jfri2/EV_FET_DRIVER/Hardware/notes.txt

===================================================================================================
Design Notes
===================================================================================================

===================================================================================================
Clock Selection

ATMEGA328PB Requirements:
 - Use external 16 MHz external clock, ceramic resonator or crystal w/out any clkdiv fuses set
 - General input reqs (assume Vcc = 5.0 VDC):
    - XTAL1 input low voltage: -0.5 to 0.5 VDC
    - XTAL1 input high voltage: 3.5 to 5.5 VDC
    - XTAL2 follows GPIO min/max. If used w/crystal or ceramic resonator reqs don't matter
 - External clock reqs:
    - 50 ns minimum clock period
    - 20 ns minimum high time
    - 20 ns minimum low time
    - Max 0.5 us rise time
    - Max 0.5 us fall time
    - 2% maximum jitter

---    
    
Ceramic Oscillator CSTCE16M0V13L99-R0 16 MHz Ceramic Resonator w/ Built in Load Capacitors

CSTCE16M0V13L99-R0
    Initial freq tolerance:                 +/- 0.1%
    Max freq shift (temperature):           +/- 0.15%
    Frequency stability:                    +/- 0.3%
                                            ---------
    Maximum frequency shift (initial):      +/- 0.55% (152 kHz)
    Maximum frequency shift (operating):    +/- 0.45% (72 kHz)
    
Benefits:
    - Small
    - Easy to use
    - Only 1 part required
    - Lowish power
    - Extremely cheap
    
Drawbacks
    - Crappy frequency stability (Up to 4500 ppm off!)
    - Uses two GPIO pins
    - Not very noise immune
 
---

External Oscillator (TTL Clock) ECS-3961-160-AU-TR 16 MHz HCMOS XO Oscillator

ECS-3961-160-AU-TR
    Frequency stability:        +/-100 ppm (+/- 1.6 kHz)
    High output:                4.5 to 5.0 VDC
    Low output:                 0.0 to 
    Output load: Max            30 pF
    Rise time: Max              5 ns
    Fall time: Max              5 ns
    Startup time:               10 ms
    Input current:              20 mA
    
Benefits:
    - Small
    - Great frequency stability
    - Cheapish
    - Very robust
    - Uses only one GPIO pin
    - Can disable output

Drawbacks:
    - Requires external decoupling capacitor
    - Slightly more invovled design

---
    
Selection: ECS-3961-160-AU-TR 16 MHz HCMOS XO Oscillator
===================================================================================================

===================================================================================================
Buck Converter/Power Supply Design

Component References
    R45      = Low value series resistor for inrush limiting (ERJ-8CWJR050V, 1206 package)
    C3/C4/C5  Bulk capacitors
    U2       = LMR16010 Buck Regulator
    C7/C9    = Input Caps (1x 4.7 uF, 1x 100nF)
    R17      = RT/SYNC resistor = 45.3 kOhm (RC0603FR-0745K3L)
    C16      = Bootstrap Capacitors
    D2       = Flyback diode
    L1       = Output inductor
    R25      = feedback resistor (high)
    R26      = feedback resistor (low)
    C21      = Output capacitor
    C25/C26  = Extra output capacitors (2x 4.7 uF, away from U2)
    C43      = Feedback cap = 27 pF (C0603C270J5GACTU)
===================================================================================================    
D2 Selection
 - All diodes must be same type on this board
 - Breakdown voltage must be > 48 VDC + 25% = 60 VDC (48 VDC is highest voltage per gate driver circuitry)
 - Must be < 0.7 Forward voltage drop @ minimum 100 mA
 - Must be tweezer-placable surface mount package
 - At least 2A cont. rated
 - Preference given to fastest & lowest forward voltage drop device that meets these requirements 

Selected component: PMEG6030ETP
 - Technology: Schottky
 - Reverse voltage: min 60 VDC
 - Reverse current: typ 80 uA
 - Forward current range (Vf < 0.7 VDC): 
 - Max Vf in range: 590 mV (3A)
 - Typical Vf for <1 A: 350 mV
 - Reverse recovery time: 12 ns
 - Capacitance: 360 pF @ 1 V, 1 MHz
 - Package: SOD-128
=================================================================================================== 
Input/Output Capacitors (all 4.7uF & 100 nF caps on board) Selection:
 - Must be X7R or X5R Ceramic
 - At least 30 VDC rated (2x 15Vin)
 - ESR < 100 mOhms @ 1 MHz
 - +/- 5% or better (100nF), +/- 10% or better (4.7uF)
 - Tweezer placable SMD package
 
Selected 4.7 uF capacitor: CL31B475KBHVPNE
 - Voltage Rating: 50 VDC
 - ESR: Lowish
 - Package: 1206
 
Selected 100nF capacitor: CC0603JRX7R9BB104
 - Voltage Rating: 50 VDC
 - ESR: < 100mOhm @ 1 MHz
 - Package: 0603
=================================================================================================== 
Bulk Capacitors
 - At least 30 VDC rated (2x 15Vin)
 - At least 150 uF each
 - ESR < 500 mOhms
 - Surface mount, lowish profile
 
Selected capacitors: AFK157M50G24T-F
 - Voltage Rating: 50 VDC
 - ESR: 180 mOhm
 - Size: 10.00 mm dia x 10.50 mm height
===================================================================================================  
Feedback Resistors
 - Output voltage set using following equation (R_top is R25, R_bot is R26):
R_top = ((5.0 VDC - 0.75) * R_bot) / 0.75
If R_top = 100 kOhm (0.1%), R_bot = 17.65 kOhm

V_actual = 4.96348 VDC
Use 1% or better resistors

Selected R_top: RC0603FR-07100KL
 - Package: 0603
Selected R_bot: RC0603FR-0717K8L
 - Package: 0603
 
TI WEBENCH Design Center:
R_top = 68.0 kOhm
R_bot = 12.0 kOhm

Selected R_Top: 68.0 kOhm
 - Package: 0603
Selected R_Bot: 12.0 kOhm
 - Package: 0603
===================================================================================================  
Output Inductor & Capacitor

Datasheet
 - Switching Frequency: 1912 kHz
 - Max input voltage: 18 VDC
 - Max peak-to-peak ripple current 
 - Kind = 50% [50 mA to 250 mA] current range
 - Inductor should be capable of 500 mArms & 1 A saturation current
 - delta_I =((Vout * (Vin_max - Vout)) / (Vin_max * L * Fsw))
 - delta_I = 0.2 * 250 mA = 50 mA
 - Lmin = ((Vin_max - Vout) / (Iout * Kind)) * (Vout / (Vin_max * Fsw))
 - Lnominal = 37.7 uH
 - Lmin = 15.1 uH
 - Needs to be ferrite inductor
 - Equates to 85% efficiency

TI WEBENCH Design Center:

Selected L: SDR0604-680KL
 - Inductance: 68.0 uH
 - ESR: 0.520 Ohm
===================================================================================================

=================================================================================================== 
MCP 6561 (Comparator) calculations

R18 & R19 resistor divider:
 - scale input down from [5.5 VDC to 18 VDC] to [0 VDC to 5 VDC] ish: 26k & 10k resistors. 10.5 VDC = 2.917 VDC out
 - Vtrip_low_to_high = around 10.5 VDC
 - Vtrip_high_to_low = around 11.0 VDC
 
 - R2 = Rtop (R22)
 - R3 = Rbot (R23), assume 10k
 - Rf = Rfeedback (R24), assume 470k
 
 - R23 = (R2 * R3) / (R2 + R3)
 - V23 = (Vdd * (R3 / (R2 + R3))) 
 - Vtrip_low_to_high = (Voh * (R23 / (R23 + Rf))) + (V23 * (Rf / (R23 + Rf)))
 - Vtrip_high_to_low = (Vol * (R23 / (R23 + Rf))) + (V23 * (Rf / (R23 + Rf)))

 w/ [R2, R3, Rf] = [6.8k, 10k, 500k]:
 - Vtrip_low_to_high = 2.9523 VDC (10.628 VDC in)
 - Vtrip_high_to_low = 2.9924 VDC (10.773 VDC in)
 
 w/ [R2, R3, Rf] = [7.2k, 10k, 500k]:
 - Vtrip_low_to_high = 2.8828 VDC (10.528 VDC in)
 - Vtrip_high_to_low = 2.9244 VDC (10.378 VDC in)
