jfri2/EV_FET_DRIVER/Hardware/3-Phase-Inverter-Controller.pdf

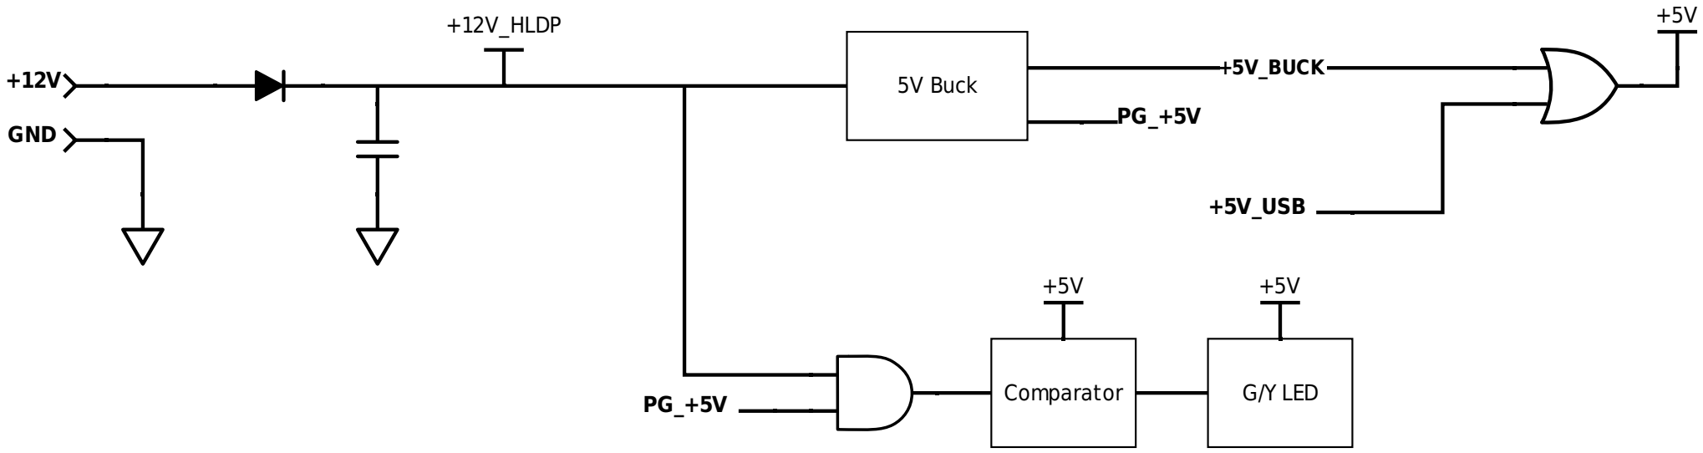
[picture p1: figure]
5V Buck; +5V_BUCK +12V; GND; +5V_USB; Comparator; G/Y LED; +12V_HLDP
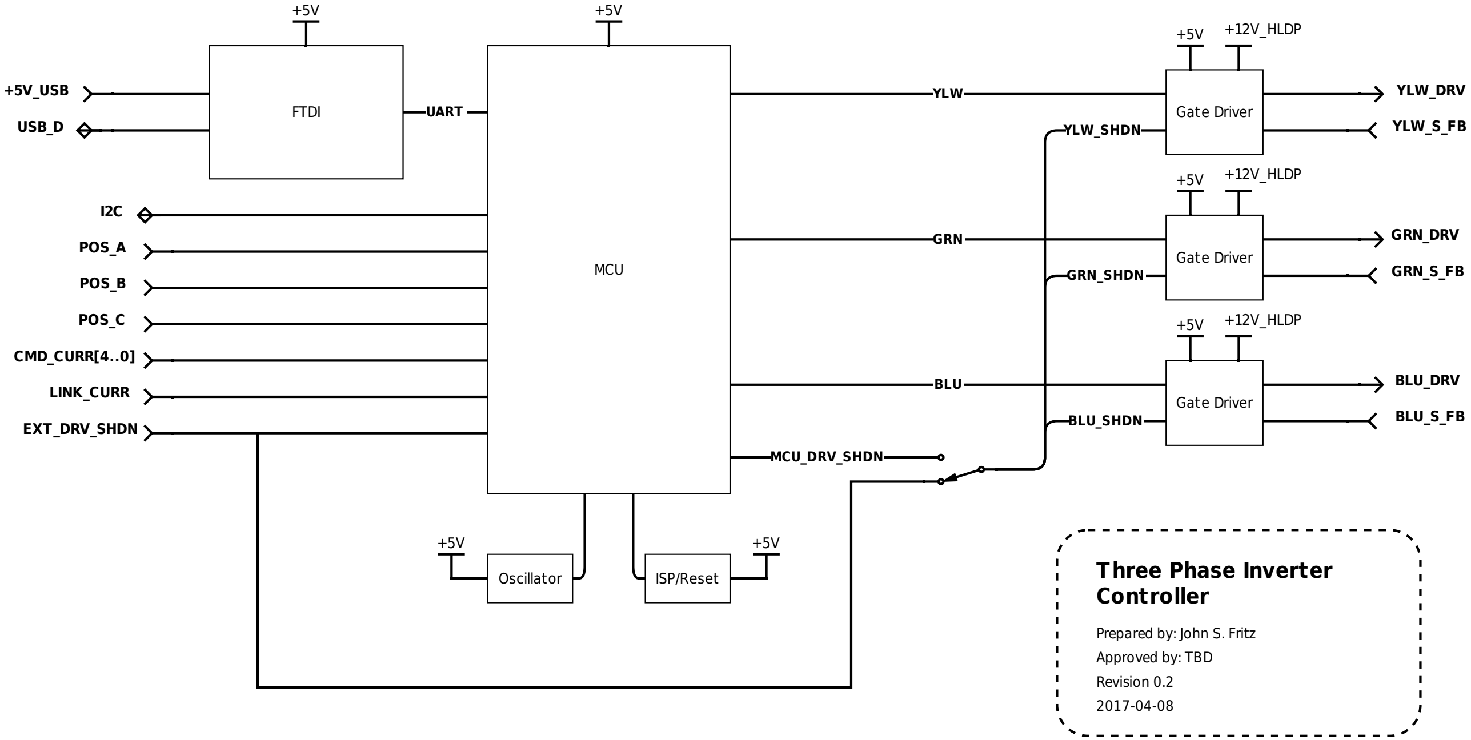
[picture p2: figure]
Three Phase Inverter Controller; Revision 0.2; Prepared by: John S. Fritz Approved by: TBD; YLW_DRV; USB_D; +5V_USB; CMD_CURR[4..0]; LINK_CURR; EXT_DRV_SHDN; FTDI; MCU; UART; Oscillator; ISP/Reset; Gate Driver; MCU_DRV_SHDN; BLU_SHDN; GRN_SHDN; YLW_SHDN; YLW; GRN; BLU; POS_C; YLW_S_FB; GRN_DRV; GRN_S_FB; BLU_DRV; BLU_S_FB; POS_A; POS_B; +12V_HLDP
