jfri2/EV_FET_DRIVER/Hardware/Three_Phase_Inverter_Controller.ods

Reference | Quantity x1 | Quantity x3 | Value | Footprint | MFG # | Comments
AA1 AA3 AA5 | 3 | 9 | OUT_1_H |  |  | Schematic ref only
AA2 AA4 AA6 | 3 | 9 | OUT_1_L |  |  | Schematic ref only
C2 | 1 | 3 | 4.5nF | 0603 | CL10B472KB8NNNC
C3 C4 C5 | 3 | 9 | 150uF | Custom | AFK157M50G24T-F
C1 C10 C11 C12 C13 C15 C16 C17 C18 C19 C22 C23 C24 C27 C30 C31 C32 C33 C40 C41 C42 C44 C6 C8 C9 | 25 | 75 | 100nF | 0603 | CC0603JRX7R9BB104
C14 C20 C21 C25 C26 C28 C29 C34 C35 C36 C37 C38 C39 C7 | 14 | 42 | 4.7uF | 1206 | CL31B475KBHVPNE
C43 | 1 | 3 | 27pF | 0603 | CL10C270JB8NNNC
D3 | 1 | 3 | LNJ167W8RRA | Custom | LNJ167W8RRA
D1 D2 D4 D5 D6 | 5 | 15 | PMEG6030ETP | SOD-128 | PMEG6030ETP
J1 | 1 | 3 | POWER | 0.1” Header, 1x2, TH R |  | Female
J3 | 1 | 3 | CURRENT | 0.1” Header, 1x8, TH R |  | Female
J4 | 1 | 3 | I2C | 0.1” Header, 1x4, TH R |  | Female
J5 | 1 | 3 | SPARE | 0.1” Header, 1x4, TH R |  | Female
J6 | 1 | 3 | UART | 0.1” Header, 1x4, TH R |  | Female
J7 | 1 | 3 | USB_B | Custom SMD USB B | 62910416121
J8 | 1 | 3 | ISP | 0.1” Header, 2x3, TH |  | Male
J2 | 1 | 3 | HALL | 0.1” Header, 1x4, TH | 282834-4 | Screw Terminal
JP1 | 1 | 3 | HALL_P_EN | 0.1” Header, 1x2, TH |  | Male
JP2 | 1 | 3 | I2C_SDA | 0.1” Header, 1x2, TH |  | Male
JP3 | 1 | 3 | I2C_SCL | 0.1” Header, 1x2, TH |  | Male
JP4 | 1 | 3 | SD | 0.1” Header, 1x2, TH |  | Male
JP5 | 1 | 3 | SHDN_SELECT | 0.1” Header, 1x3, TH |  | Male
L1 | 1 | 3 | 68uH | Custom | SDR0604-680KL
Q1 Q2 Q3 Q4 Q5 Q6 | 0 | 0 | IXFN110N60P3 | Custom |  | Already owned
Q7 | 1 | 3 | BSS806NE | SOT-23 | BSS806NE
R1 | 1 | 3 | 1M | 0603 | RC0603JR-071ML
R12 R13 R14 R15 R16 | 5 | 15 | 0R | 0603 | RC0603JR-070RL
R17 | 1 | 3 | 45.3k | 0603 | RC0603FR-0745K3L
R18 | 1 | 3 | 26.1k | 0603 | RC0603FR-0726K1L
R20 R21 | 2 | 6 | 27R | 0603 | RC0603FR-0727RL
R22 | 1 | 3 | 6.8k | 0603 | RC0603FR-076K8L
R24 | 1 | 3 | 470k | 0603 | RC0603FR-07470KL
R25 | 1 | 3 | 68k | 0603 | RC0603FR-0768KL
R26 | 1 | 3 | 12k | 0603 | RC0603FR-0712KL
R29 R30 | 2 | 6 | 180R | 0805 | ERJ-P06J181V
R33 R34 R35 R36 R37 R38 | 6 | 18 | 10R | 0805 | RNCP0805FTD10R0
R10 R11 R19 R2 R23 R27 R28 R3 R31 R32 R39 R4 R40 R41 R42 R43 R44 R46 R5 R6 R7 R8 R9 | 23 | 69 | 10k | 0603 | RC0603FR-0710KL
R45 | 1 | 3 | 0.05R | 1206 | ERJ-8CWJR050V
SW1 | 1 | 3 | ~MCU_RST | 3342 (Switch) | TL3342F160QG/TR
TP1 | 1 | 3 | CBUS1 | 0805 | 5019 | 36-5019CT-ND
TP2 | 1 | 3 | CBUS2 | 0805 | 5019 | 36-5019CT-ND
TP3 | 1 | 3 | CBUS3 | 0805 | 5019 | 36-5019CT-ND
TP4 | 1 | 3 | VIN | 0805 | 5019 | 36-5019CT-ND
TP5 | 1 | 3 | +12V | 0805 | 5019 | 36-5019CT-ND
TP6 | 1 | 3 | 12V_HLDP | 0805 | 5019 | 36-5019CT-ND
TP7 | 1 | 3 | 5V_BUCK | 0805 | 5019 | 36-5019CT-ND
TVS1 | 1 | 3 | PRTR5V0U2X | TO-253-4 | PRTR5V0U2X
U1 | 1 | 3 | TPS22810 | SOT-23-6 | TPS22810DBVR
U2 | 1 | 3 | LMR16010 | 8-SO PowerPad | LMR16010PDDA
U3 | 1 | 3 | MCP6561 | SOT-23-5 | MCP6561T-E/OT
U4 | 1 | 3 | FT230XS | 16-SSOP | FT230XS-U
U5 | 0 | 0 | ATMEGA328PB-AU | 32-TQFP | ATMEGA328PB-AU | (Already Owned)
U6 | 1 | 3 | SN74LVC1G04-Q1 | SOT-23-5 | SN74LVC1G04QDBVRQ1
U7 | 1 | 3 | LTC4413 | 10-WFDFN Exposed Pad | LTC4413EDD#TRPBF
U8 | 1 | 3 | ECS-3961 | 4-SMD Crystal | ECS-3961-160-AU-TR
U10 U11 U9 | 3 | 9 | IR2110S | 16-SOIC (wide) | IR2110SPBF
