jfri2/EV_FET_DRIVER/Hardware/PDFs/Three_Phase_Inverter_Controller-F.SilkS.pdf

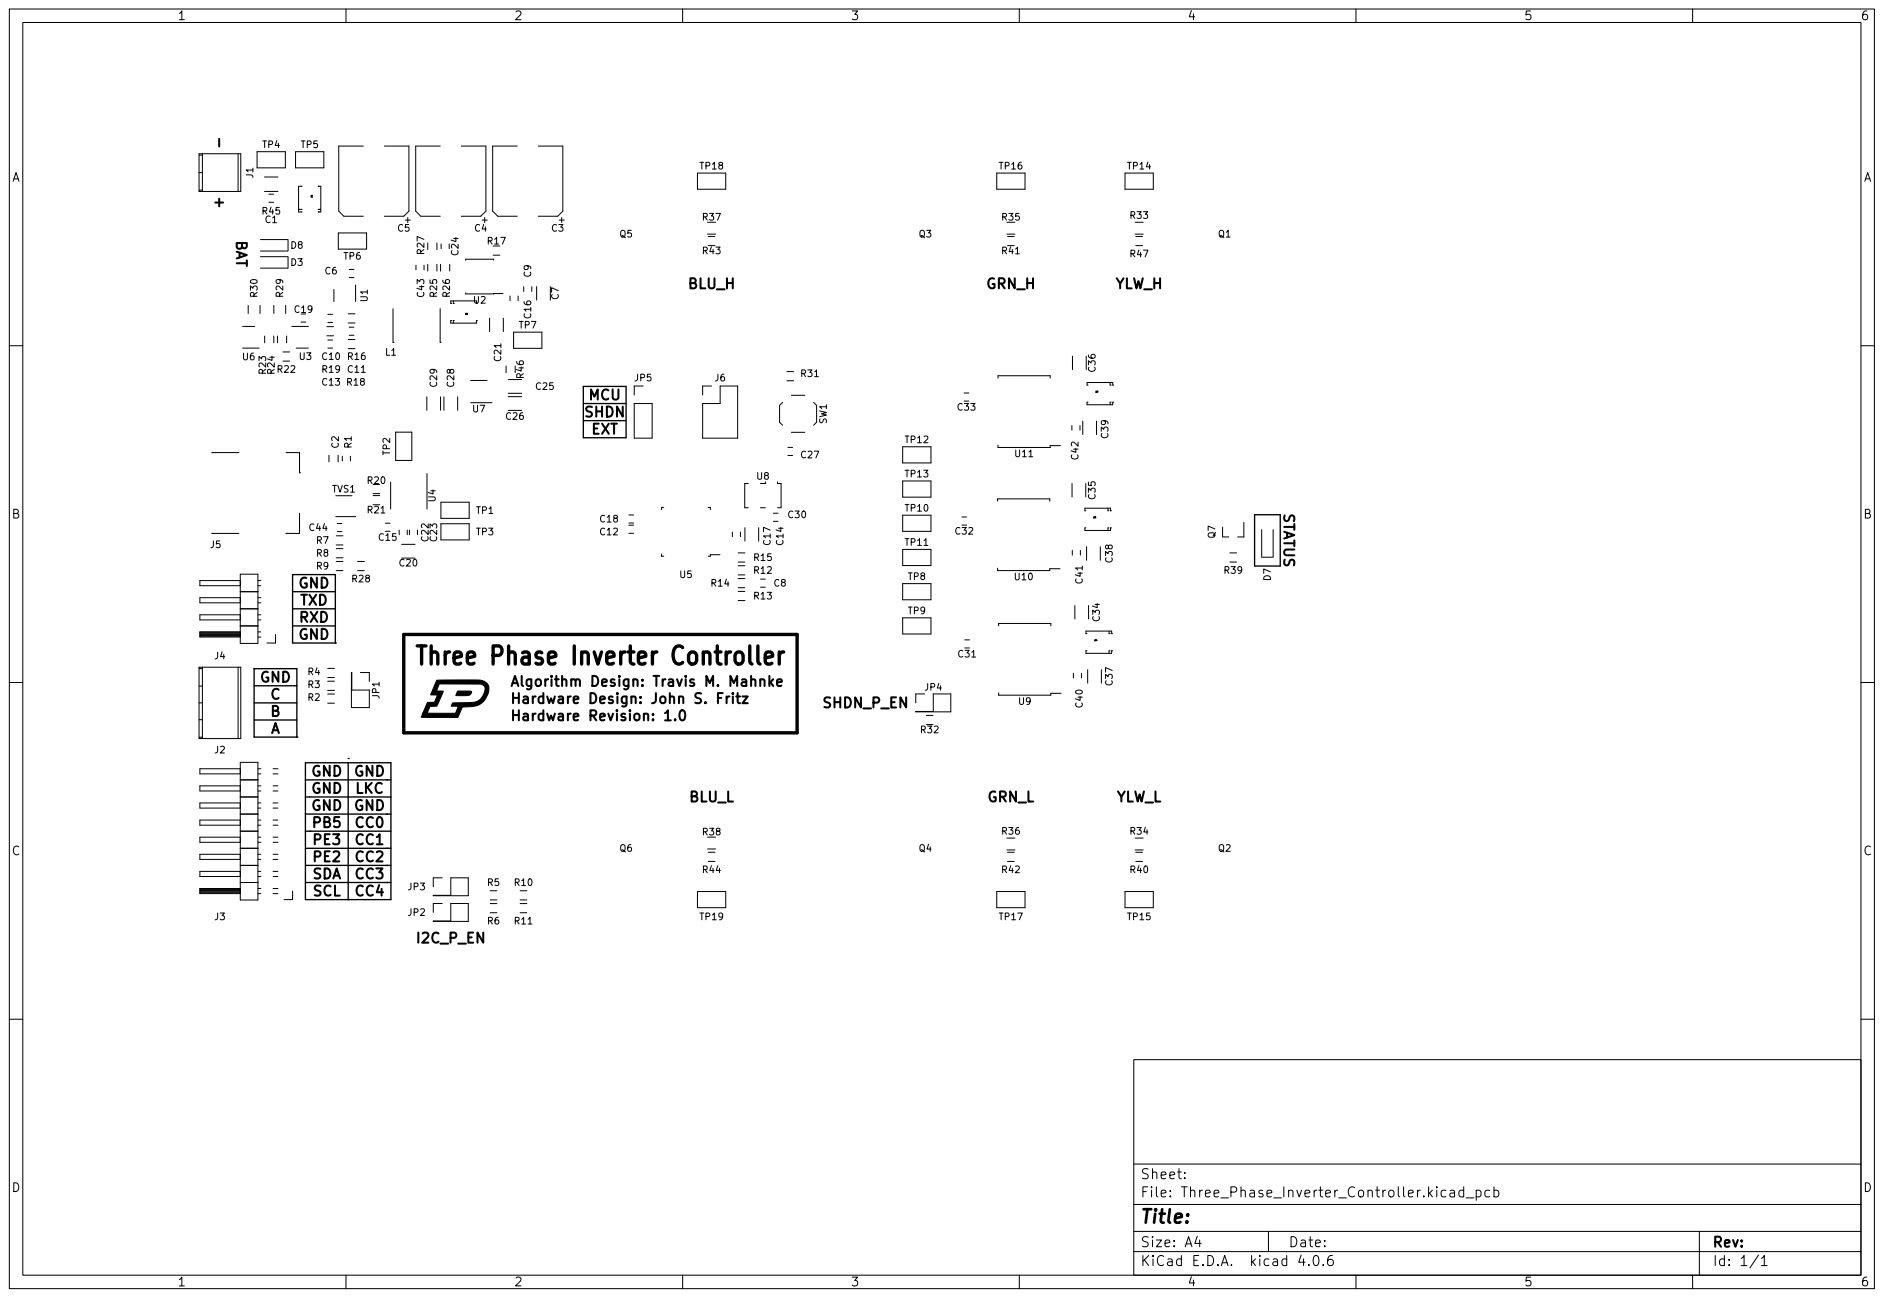
[picture p3: page 1]

EXT Three Phase Inverter Controller

File: Three_Phase_Inverter_Controller.kicad_pcb Sheet: Algorithm Design: Travis M. Mahnke
