jfri2/EV_FET_DRIVER/Hardware/PDFs/Three_Phase_Inverter_Controller-B.CrtYd.pdf

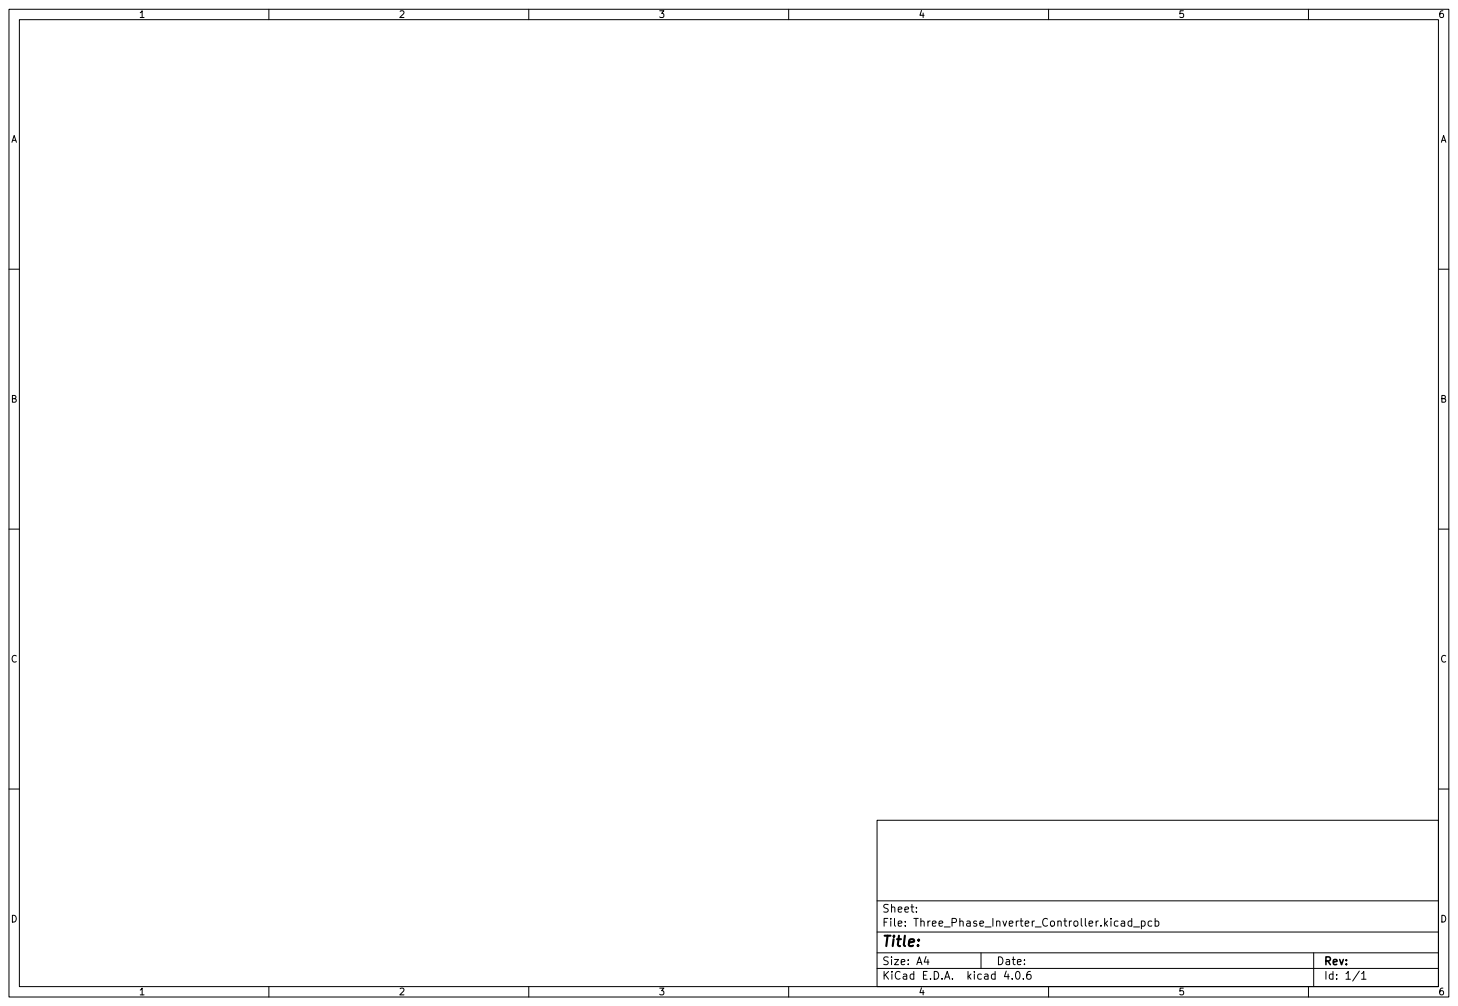
[picture p4: page 1]
