jfri2/EV_FET_DRIVER/Hardware/PDFs/Three_Phase_Inverter_Controller-B.Cu.pdf

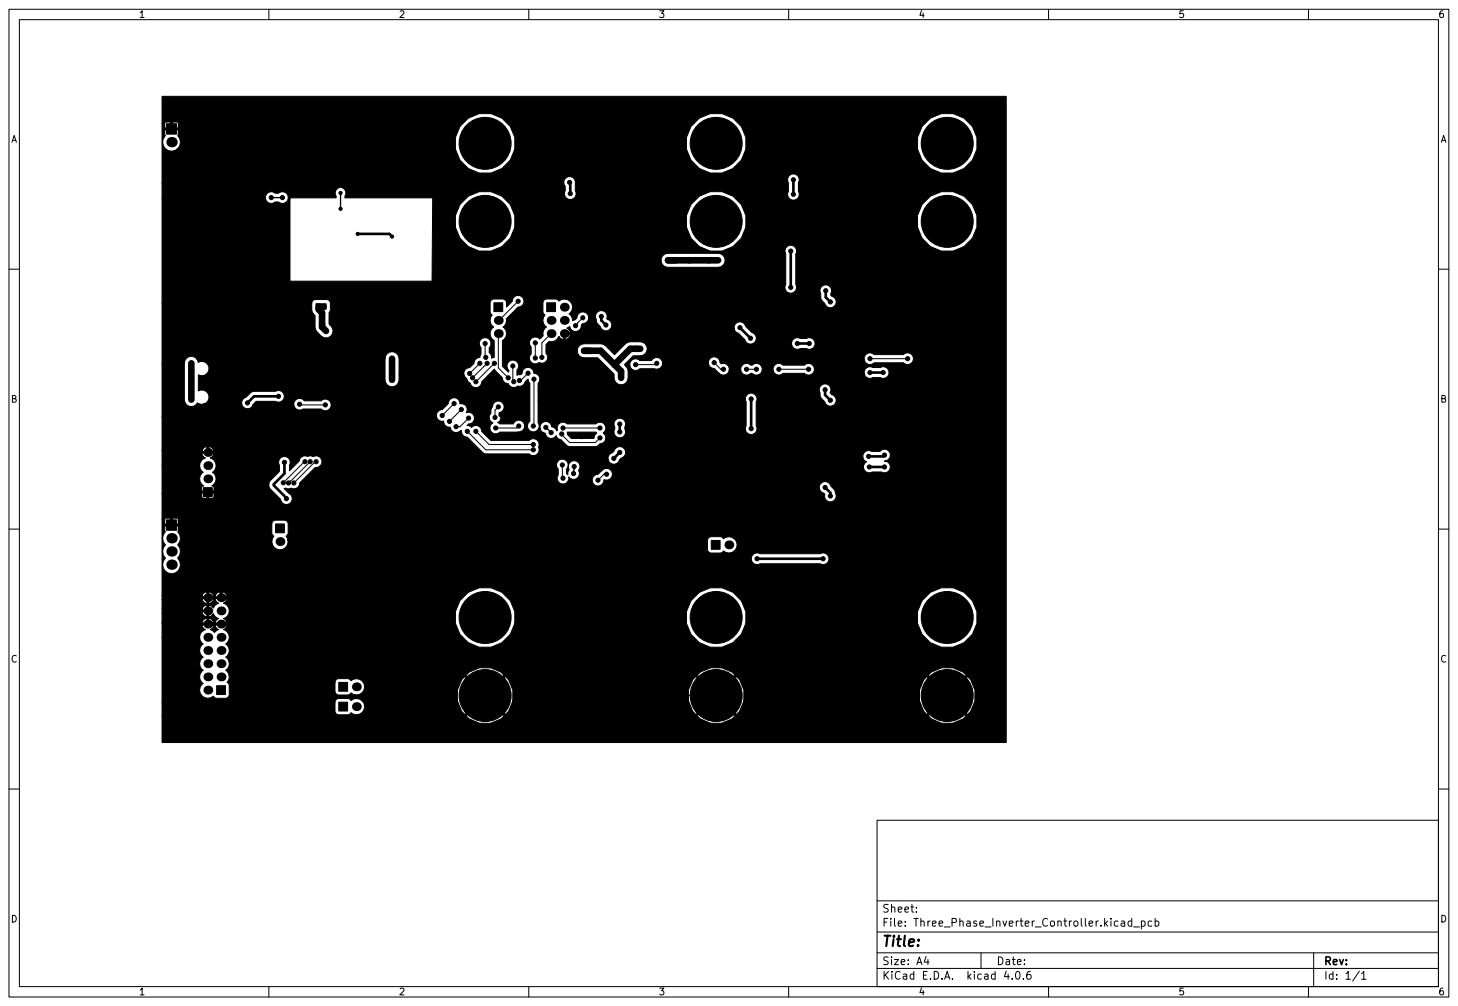
[picture p5: page 1]
