jfri2/EV_FET_DRIVER/Hardware/PDFs/Three_Phase_Inverter_Controller-B.Mask.pdf

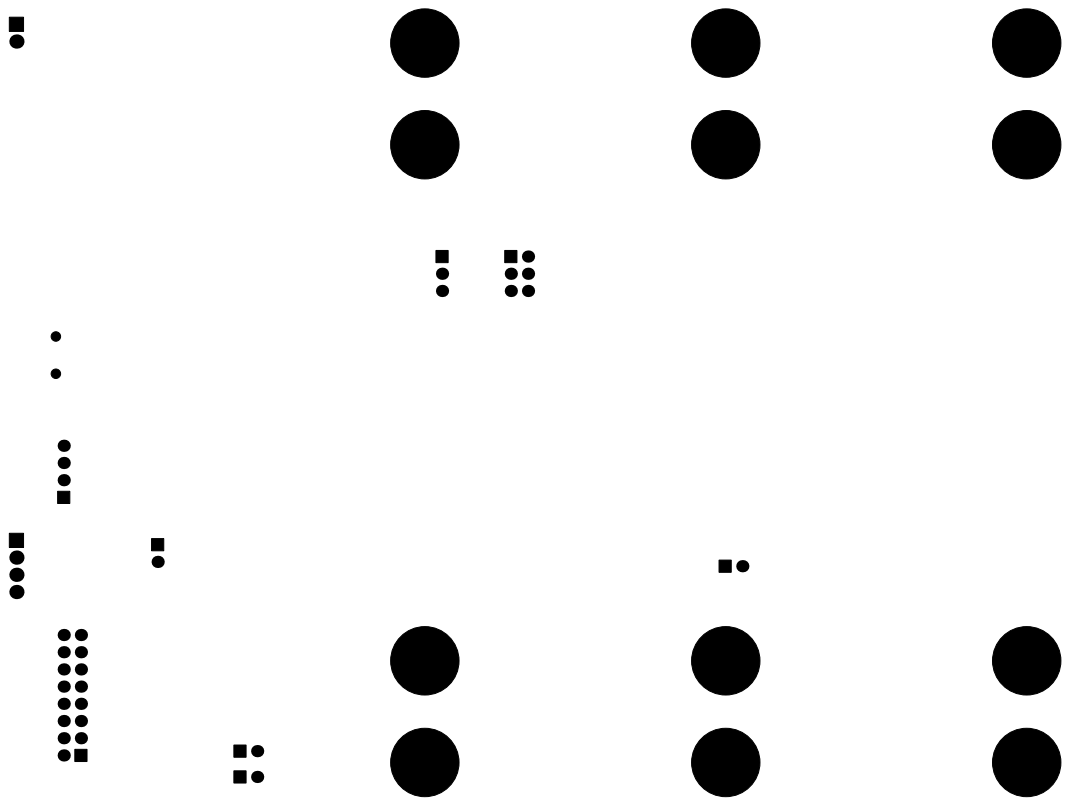
[picture p6: page 1]
