jfri2/EV_FET_DRIVER/Hardware/PDFs/Three_Phase_Inverter_Controller-Eco1.User.pdf

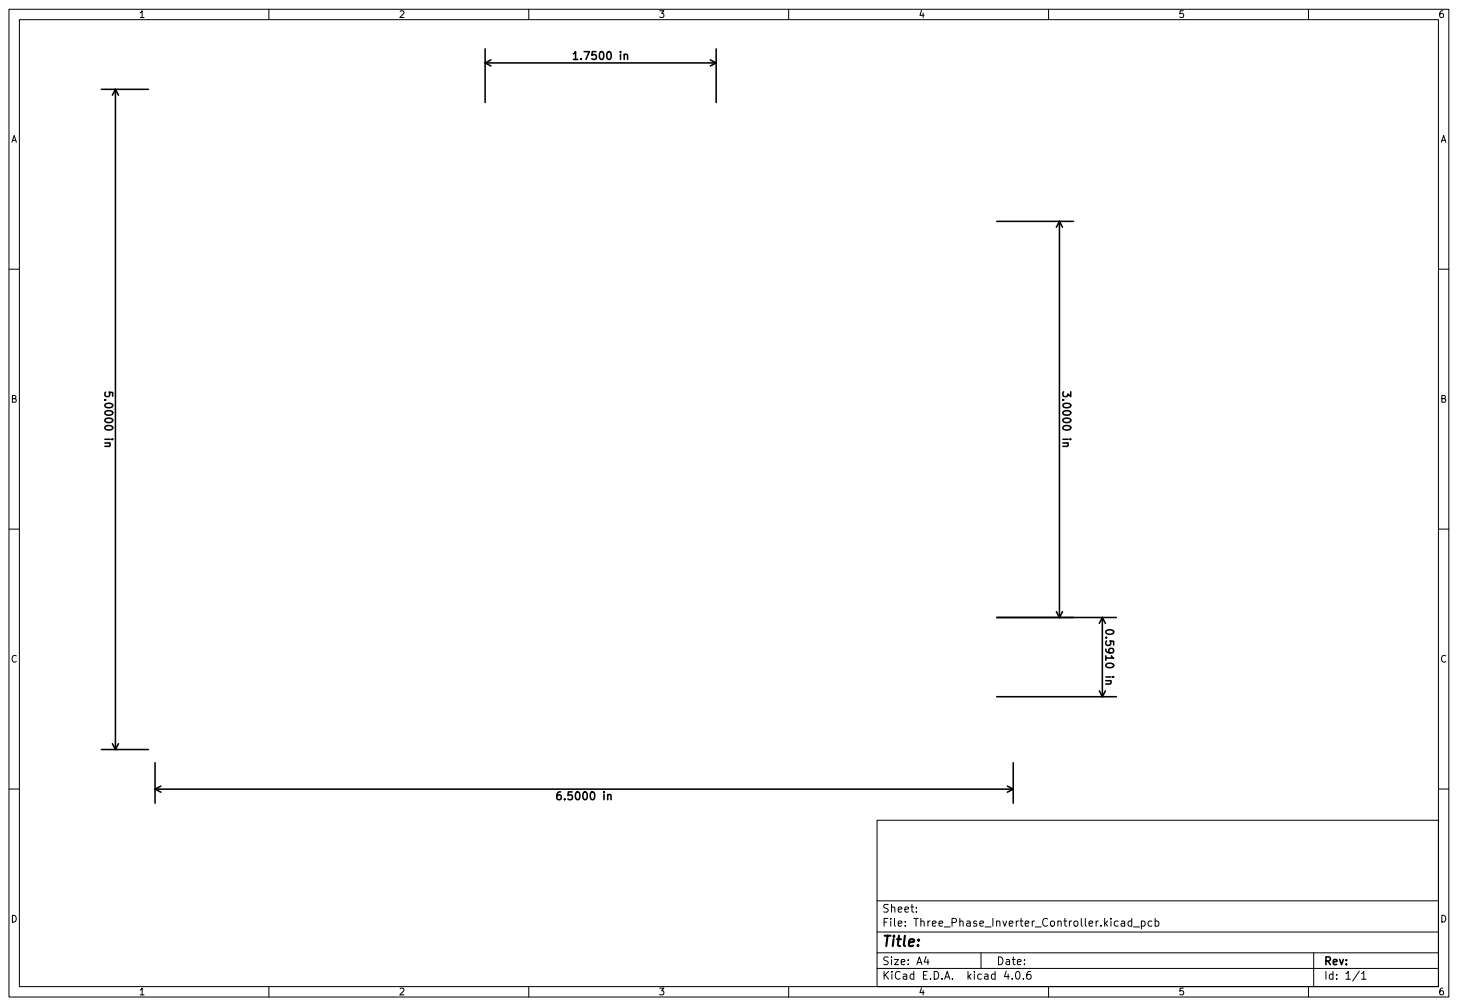
[picture p7: page 1]
