jfri2/EV_FET_DRIVER/Hardware/PDFs/Three_Phase_Inverter_Controller-Edge.Cuts.pdf

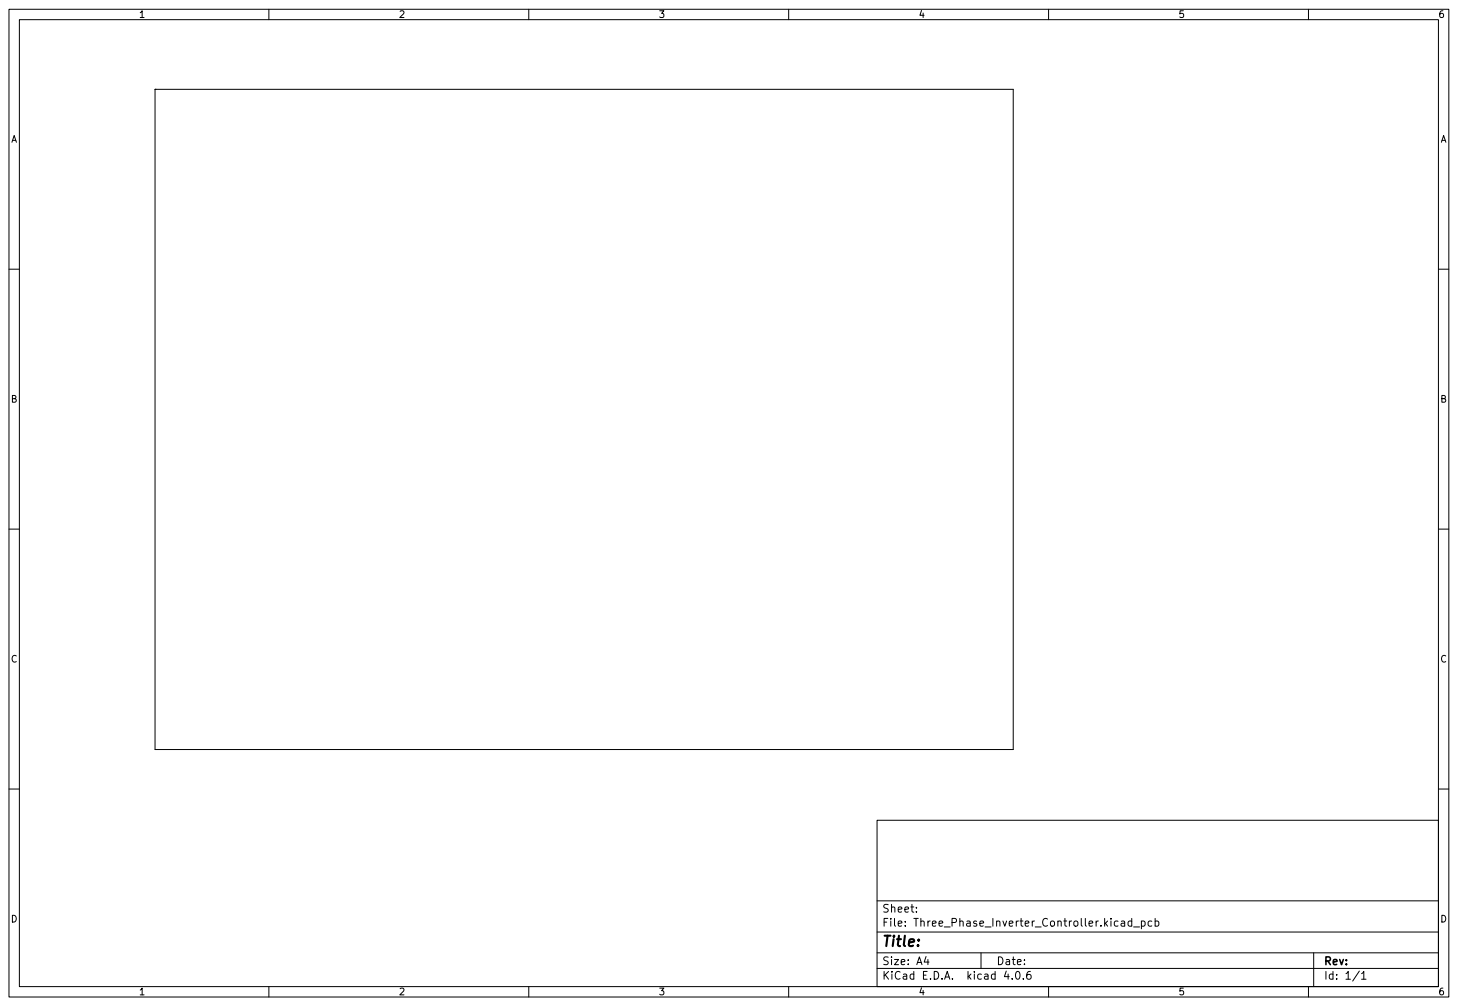
[picture p8: page 1]
