jfri2/EV_FET_DRIVER/Hardware/PDFs/Three_Phase_Inverter_Controller-F.CrtYd.pdf

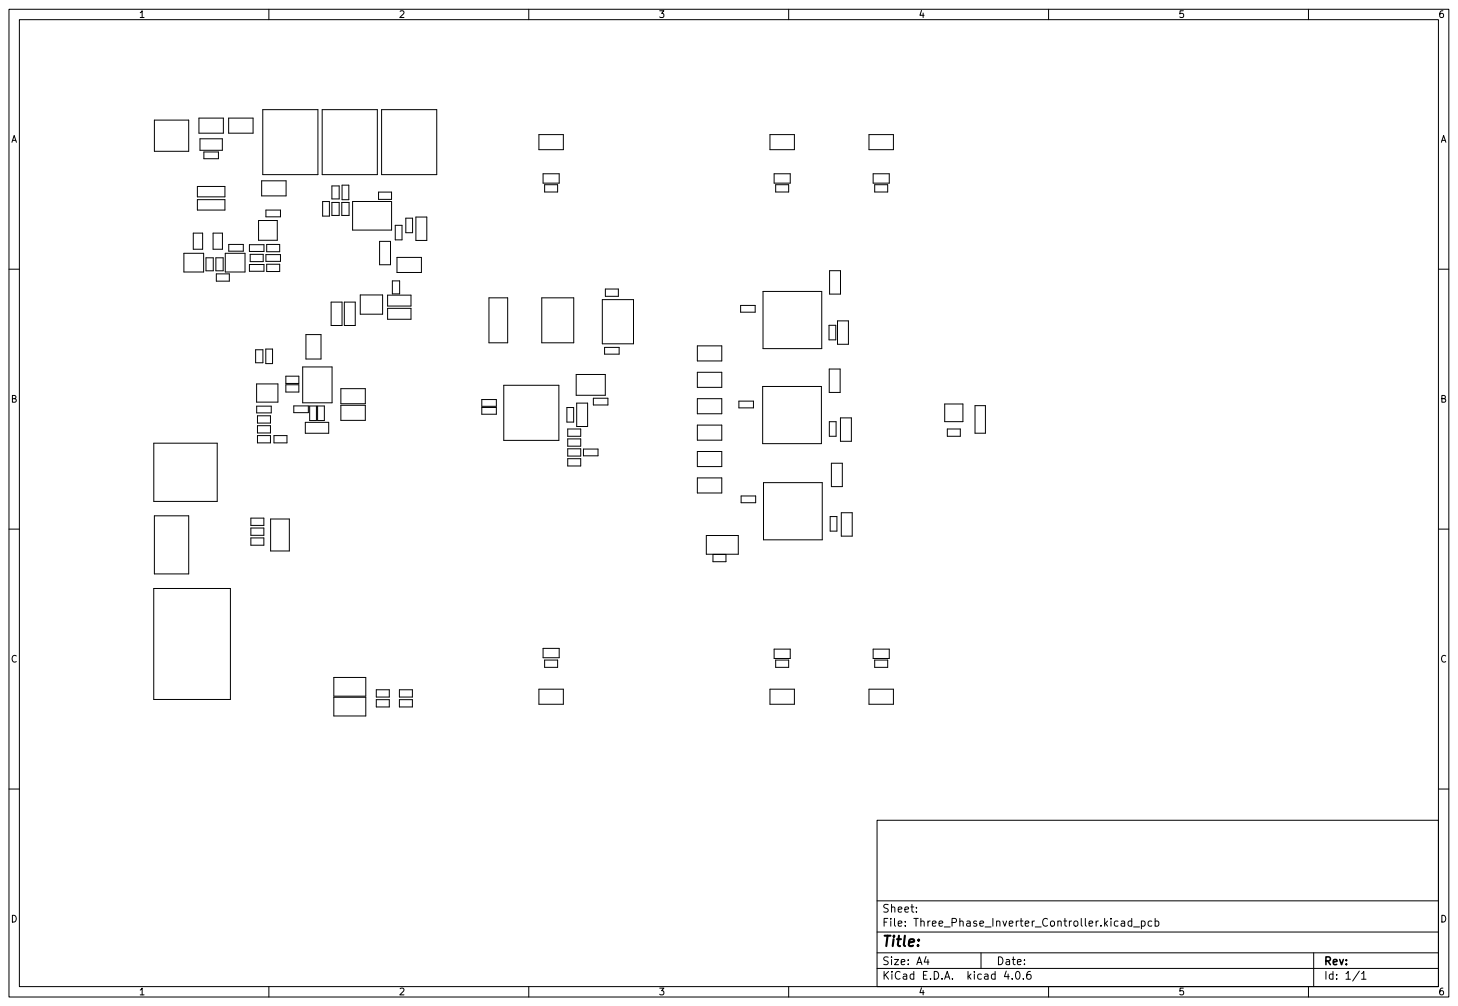
[picture p9: page 1]
