jfri2/EV_FET_DRIVER/Hardware/PDFs/Three_Phase_Inverter_Controller-F.Cu.pdf

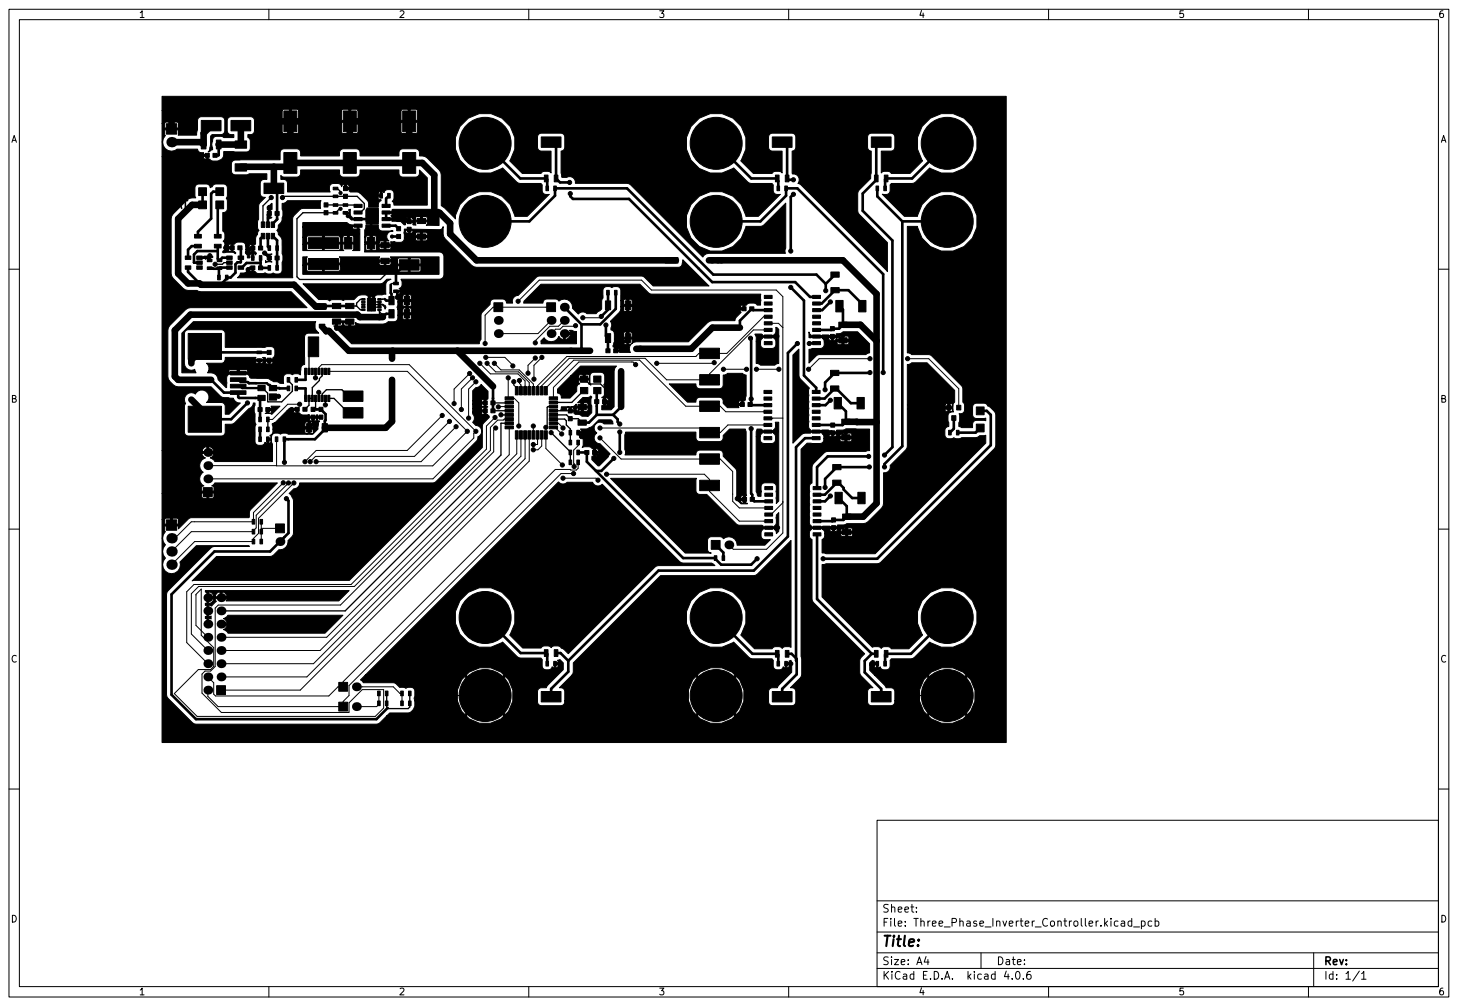
[picture p10: page 1]
