jfri2/EV_FET_DRIVER/Hardware/PDFs/Three_Phase_Inverter_Controller-F.Mask.pdf

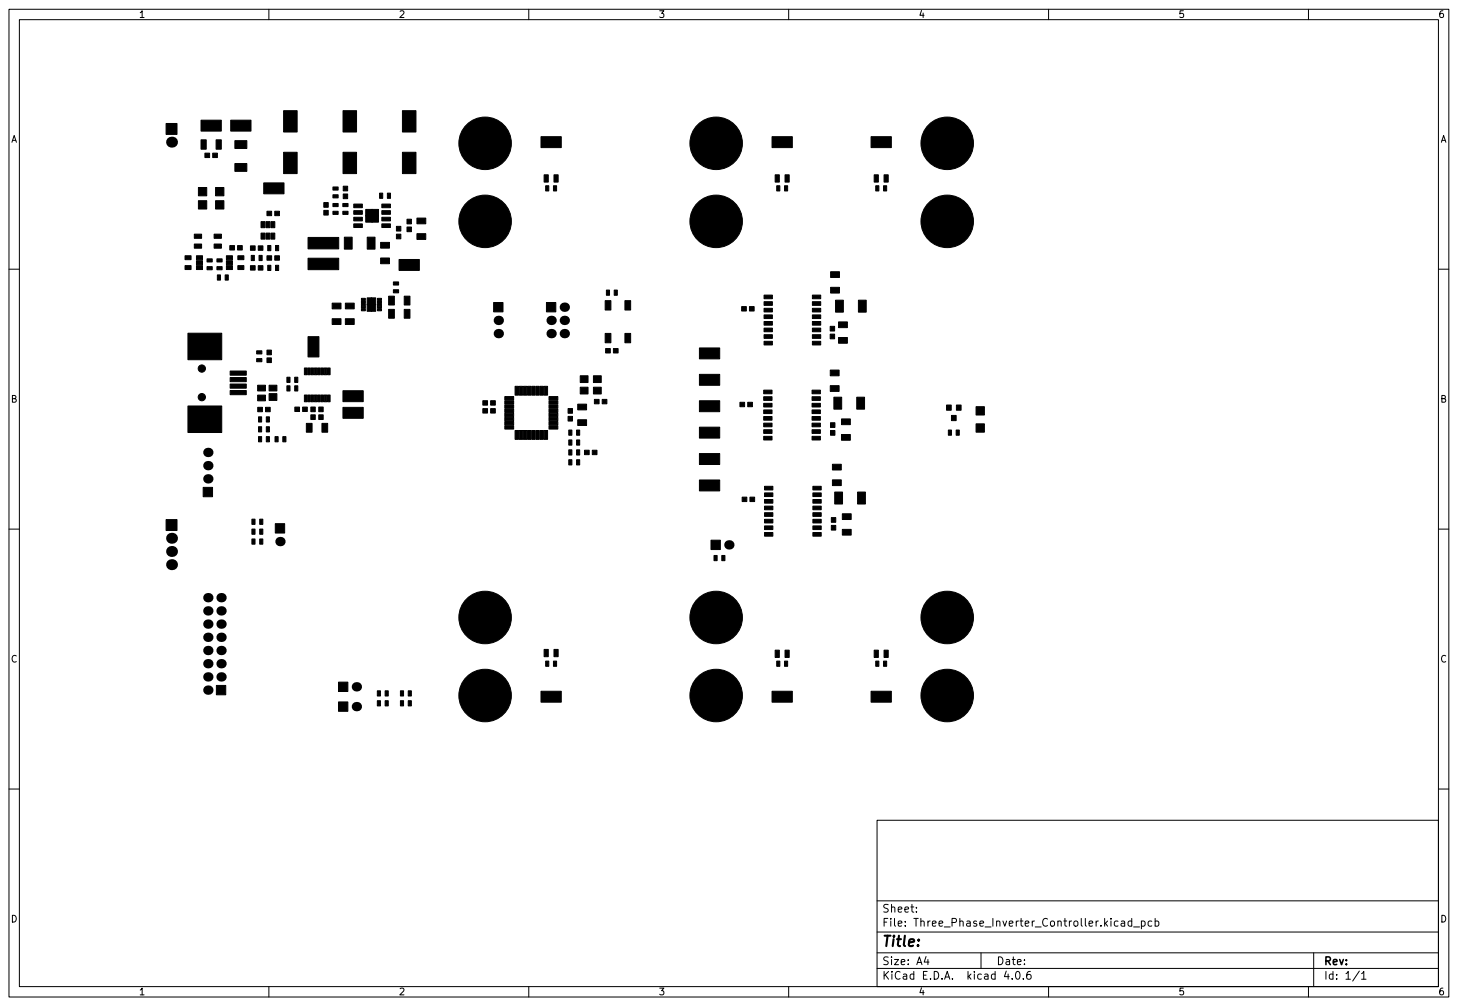
[picture p11: page 1]
