jfri2/EV_FET_DRIVER/Hardware/PDFs/Three_Phase_Inverter_Controller-F.Paste.pdf

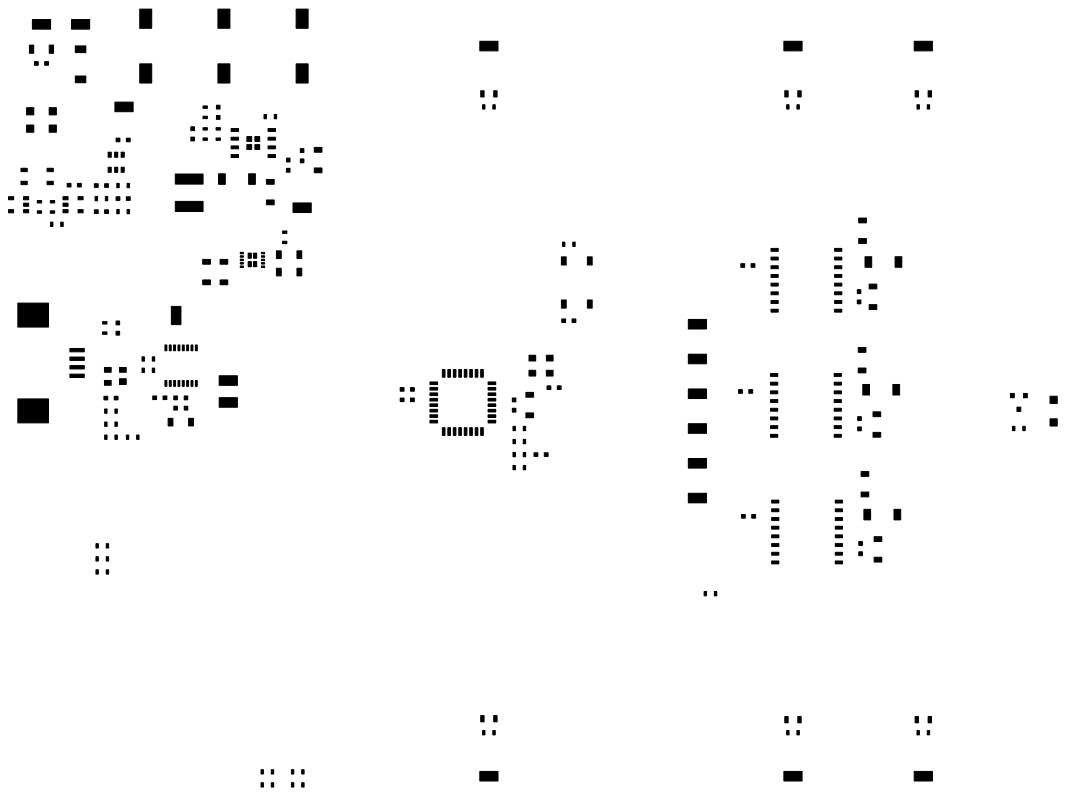
[picture p12: page 1]
