jfri2/EV_FET_DRIVER/Hardware/PDFs/Three_Phase_Inverter_Controller_SilkCheck.pdf

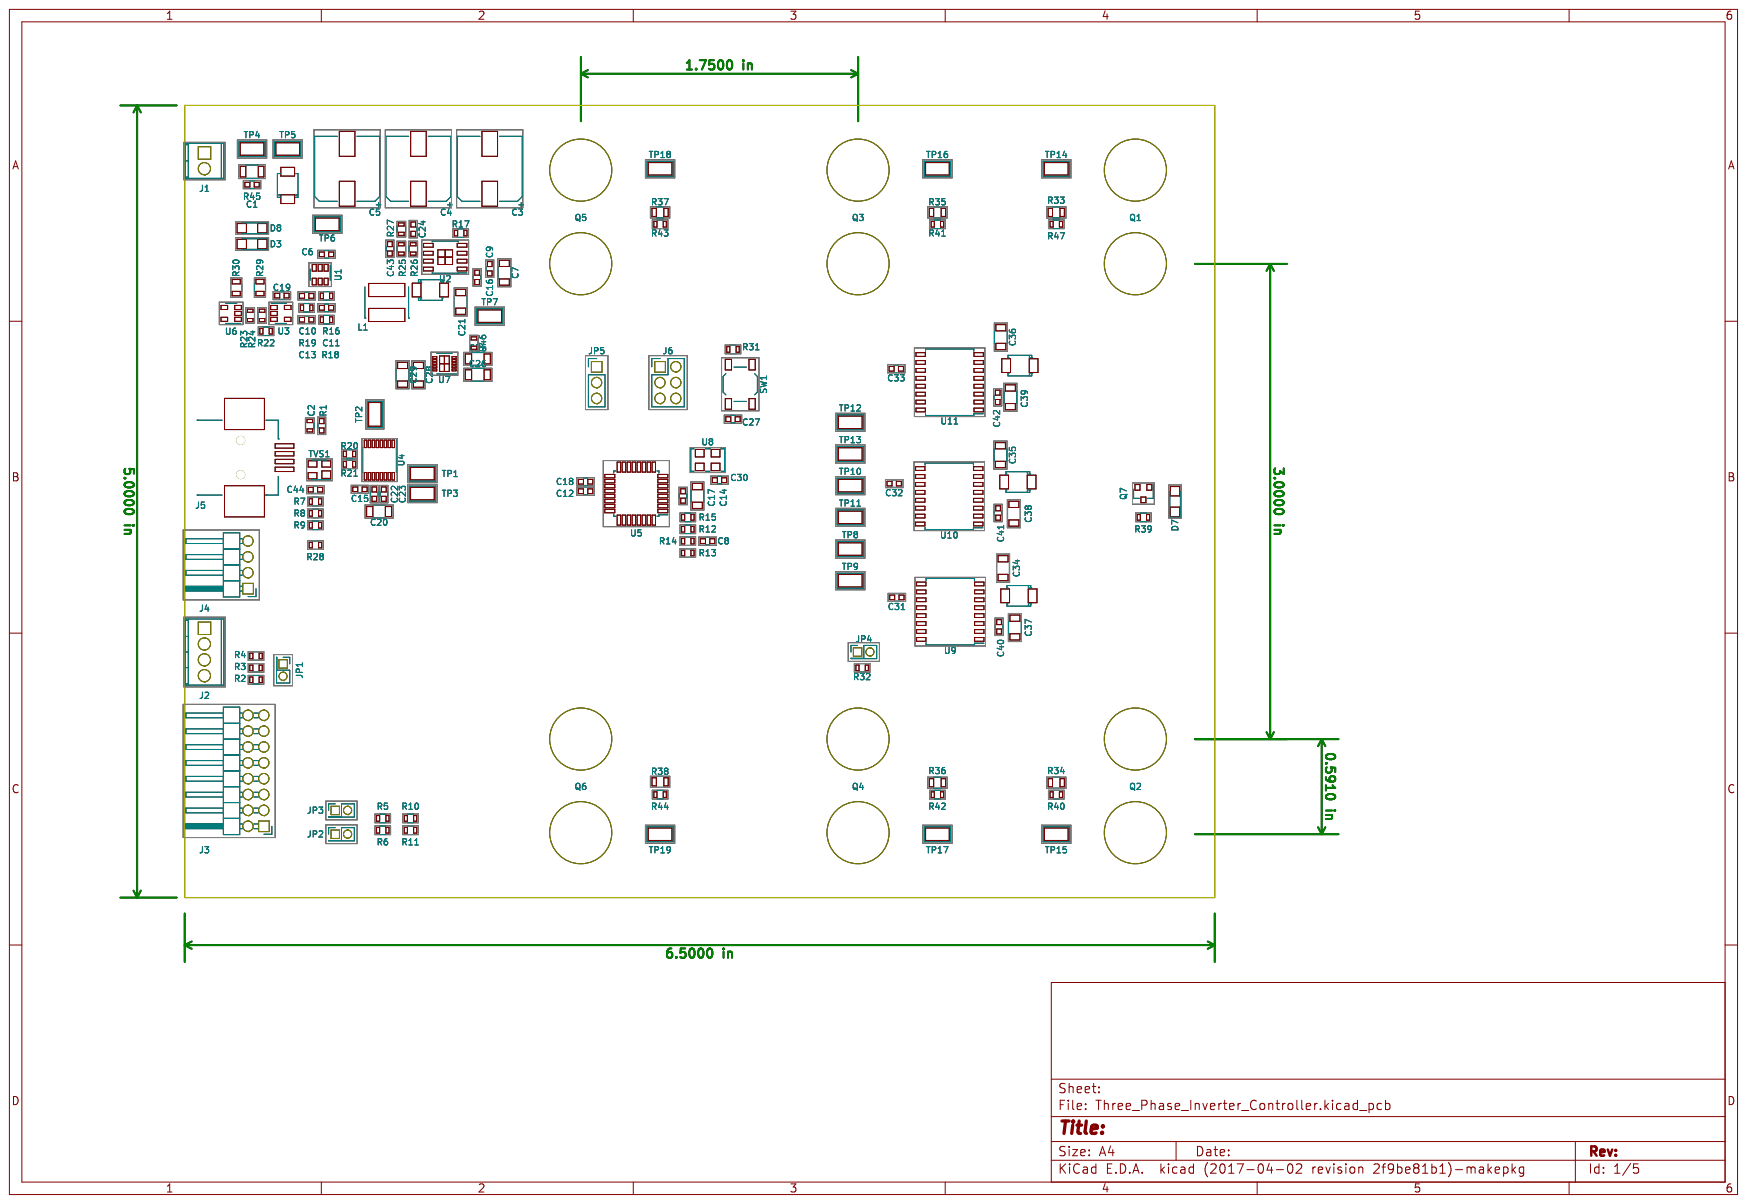
[picture p13: page 1]
