jfri2/EV_FET_DRIVER/Hardware/PDFs/Three_Phase_Inverter_Controller.pdf

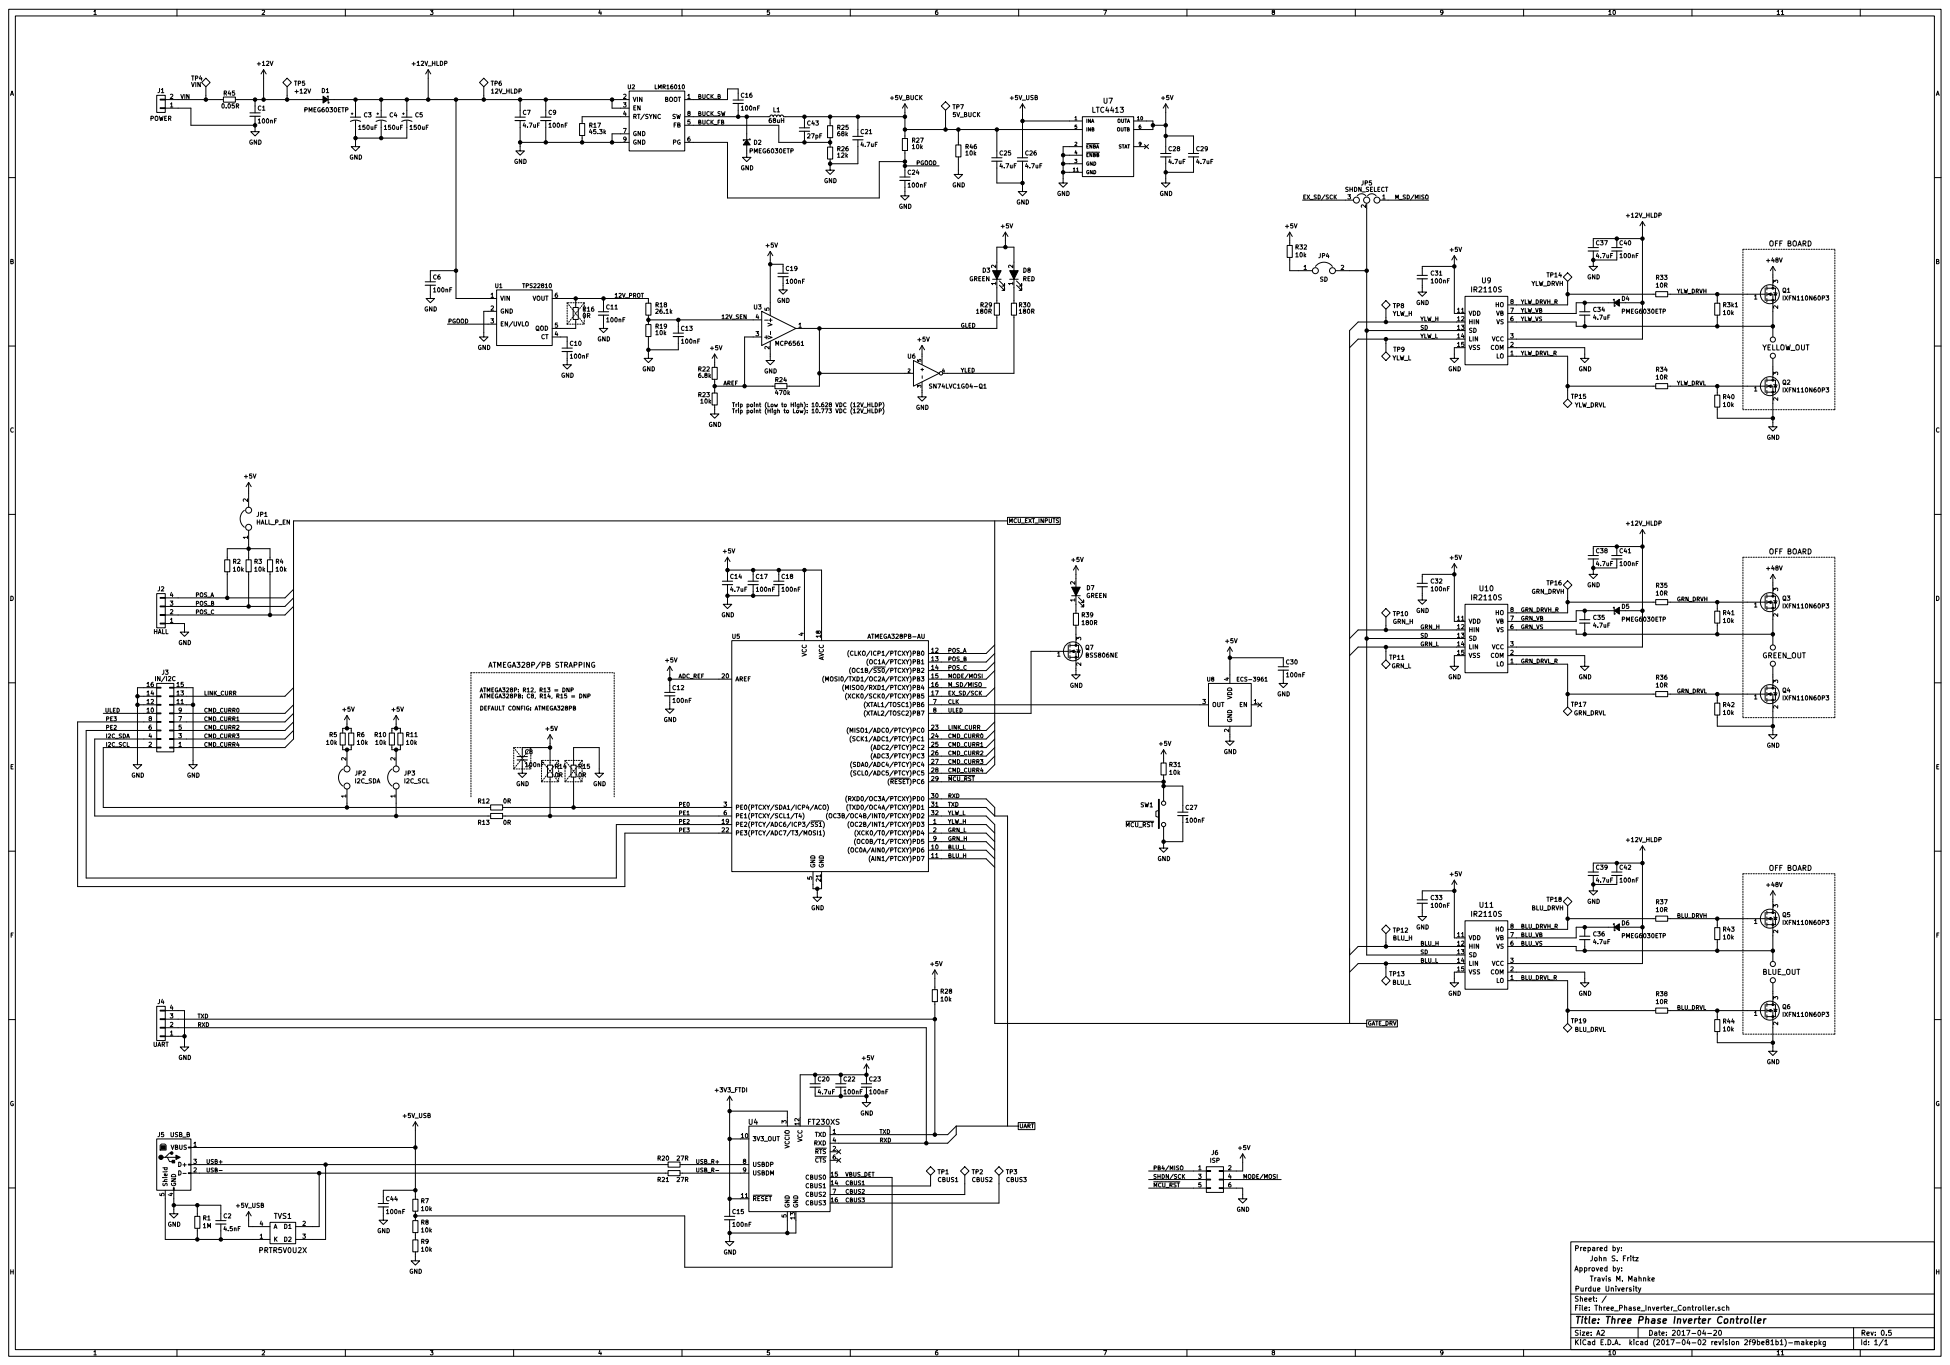
[picture p14: page 1]

Trip point (Low to High): 10.628 VDC (12V_HLDP)
Trip point (High to Low): 10.773 VDC (12V_HLDP)

John S. Fritz Prepared by:

Travis M. Mahnke Approved by:

File: Three_Phase_Inverter_Controller.sch Sheet: / Purdue University

Id: 1/1 Title: Three Phase Inverter Controller
