jfri2/EV_FET_DRIVER/Hardware/Three_Phase_Inverter_Controller.kicad_pcb

## KiCad design Hardware/Three_Phase_Inverter_Controller.kicad_pcb (2017-05-15)

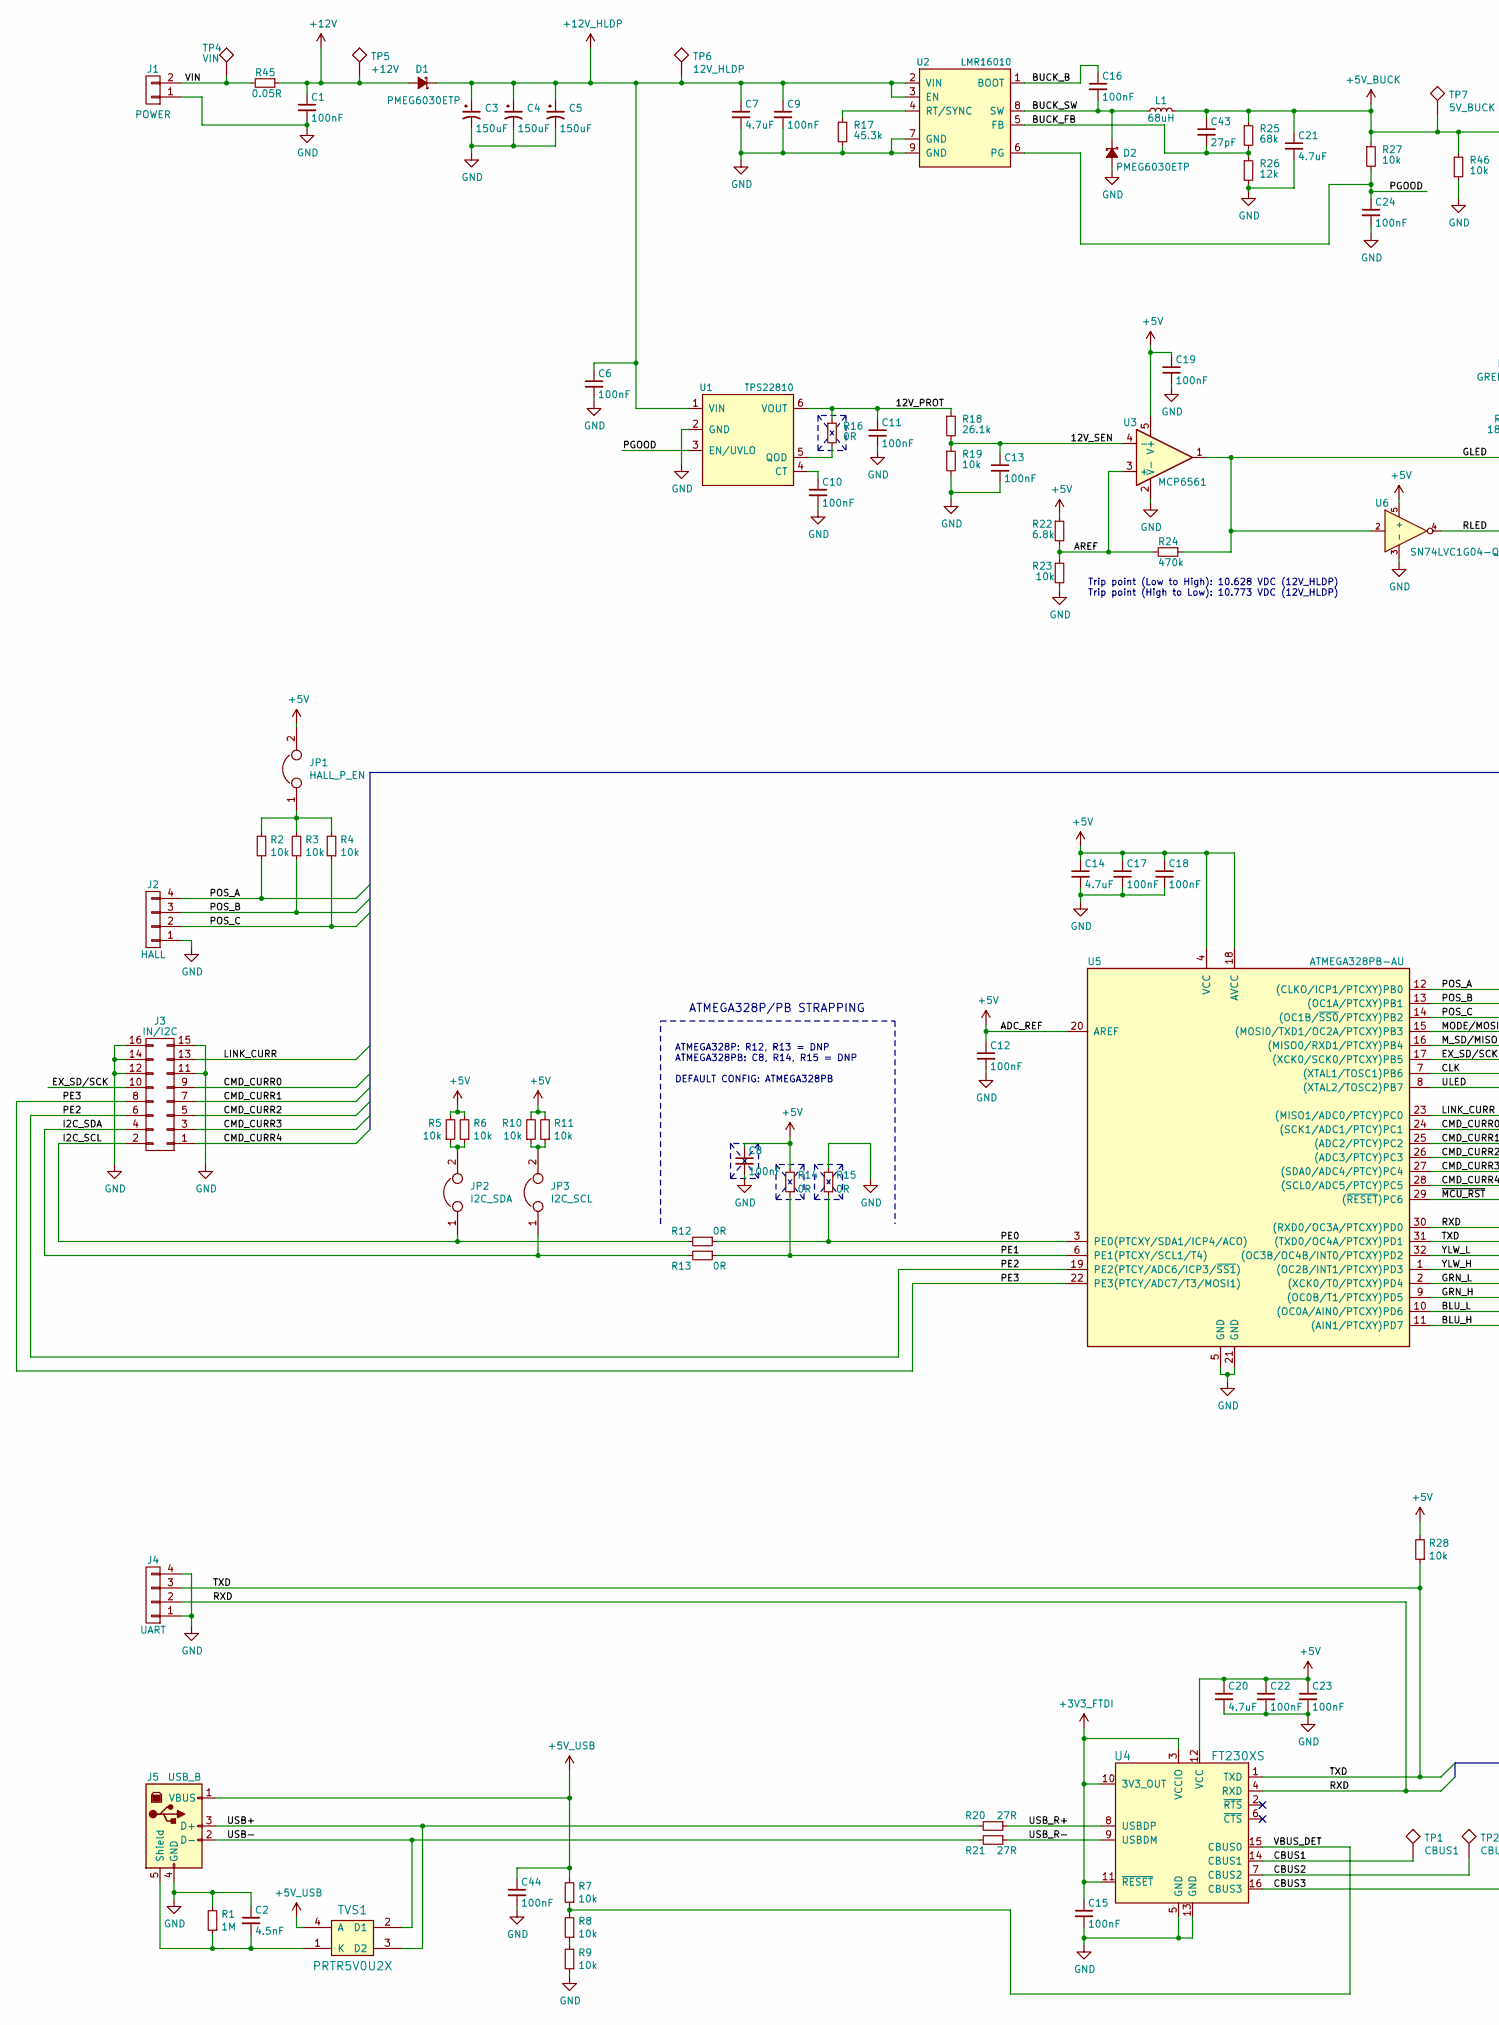
[picture p15: schematic Three_Phase_Inverter_Controller.sch, Three Phase Inverter Controller, part in row 1, column 1]

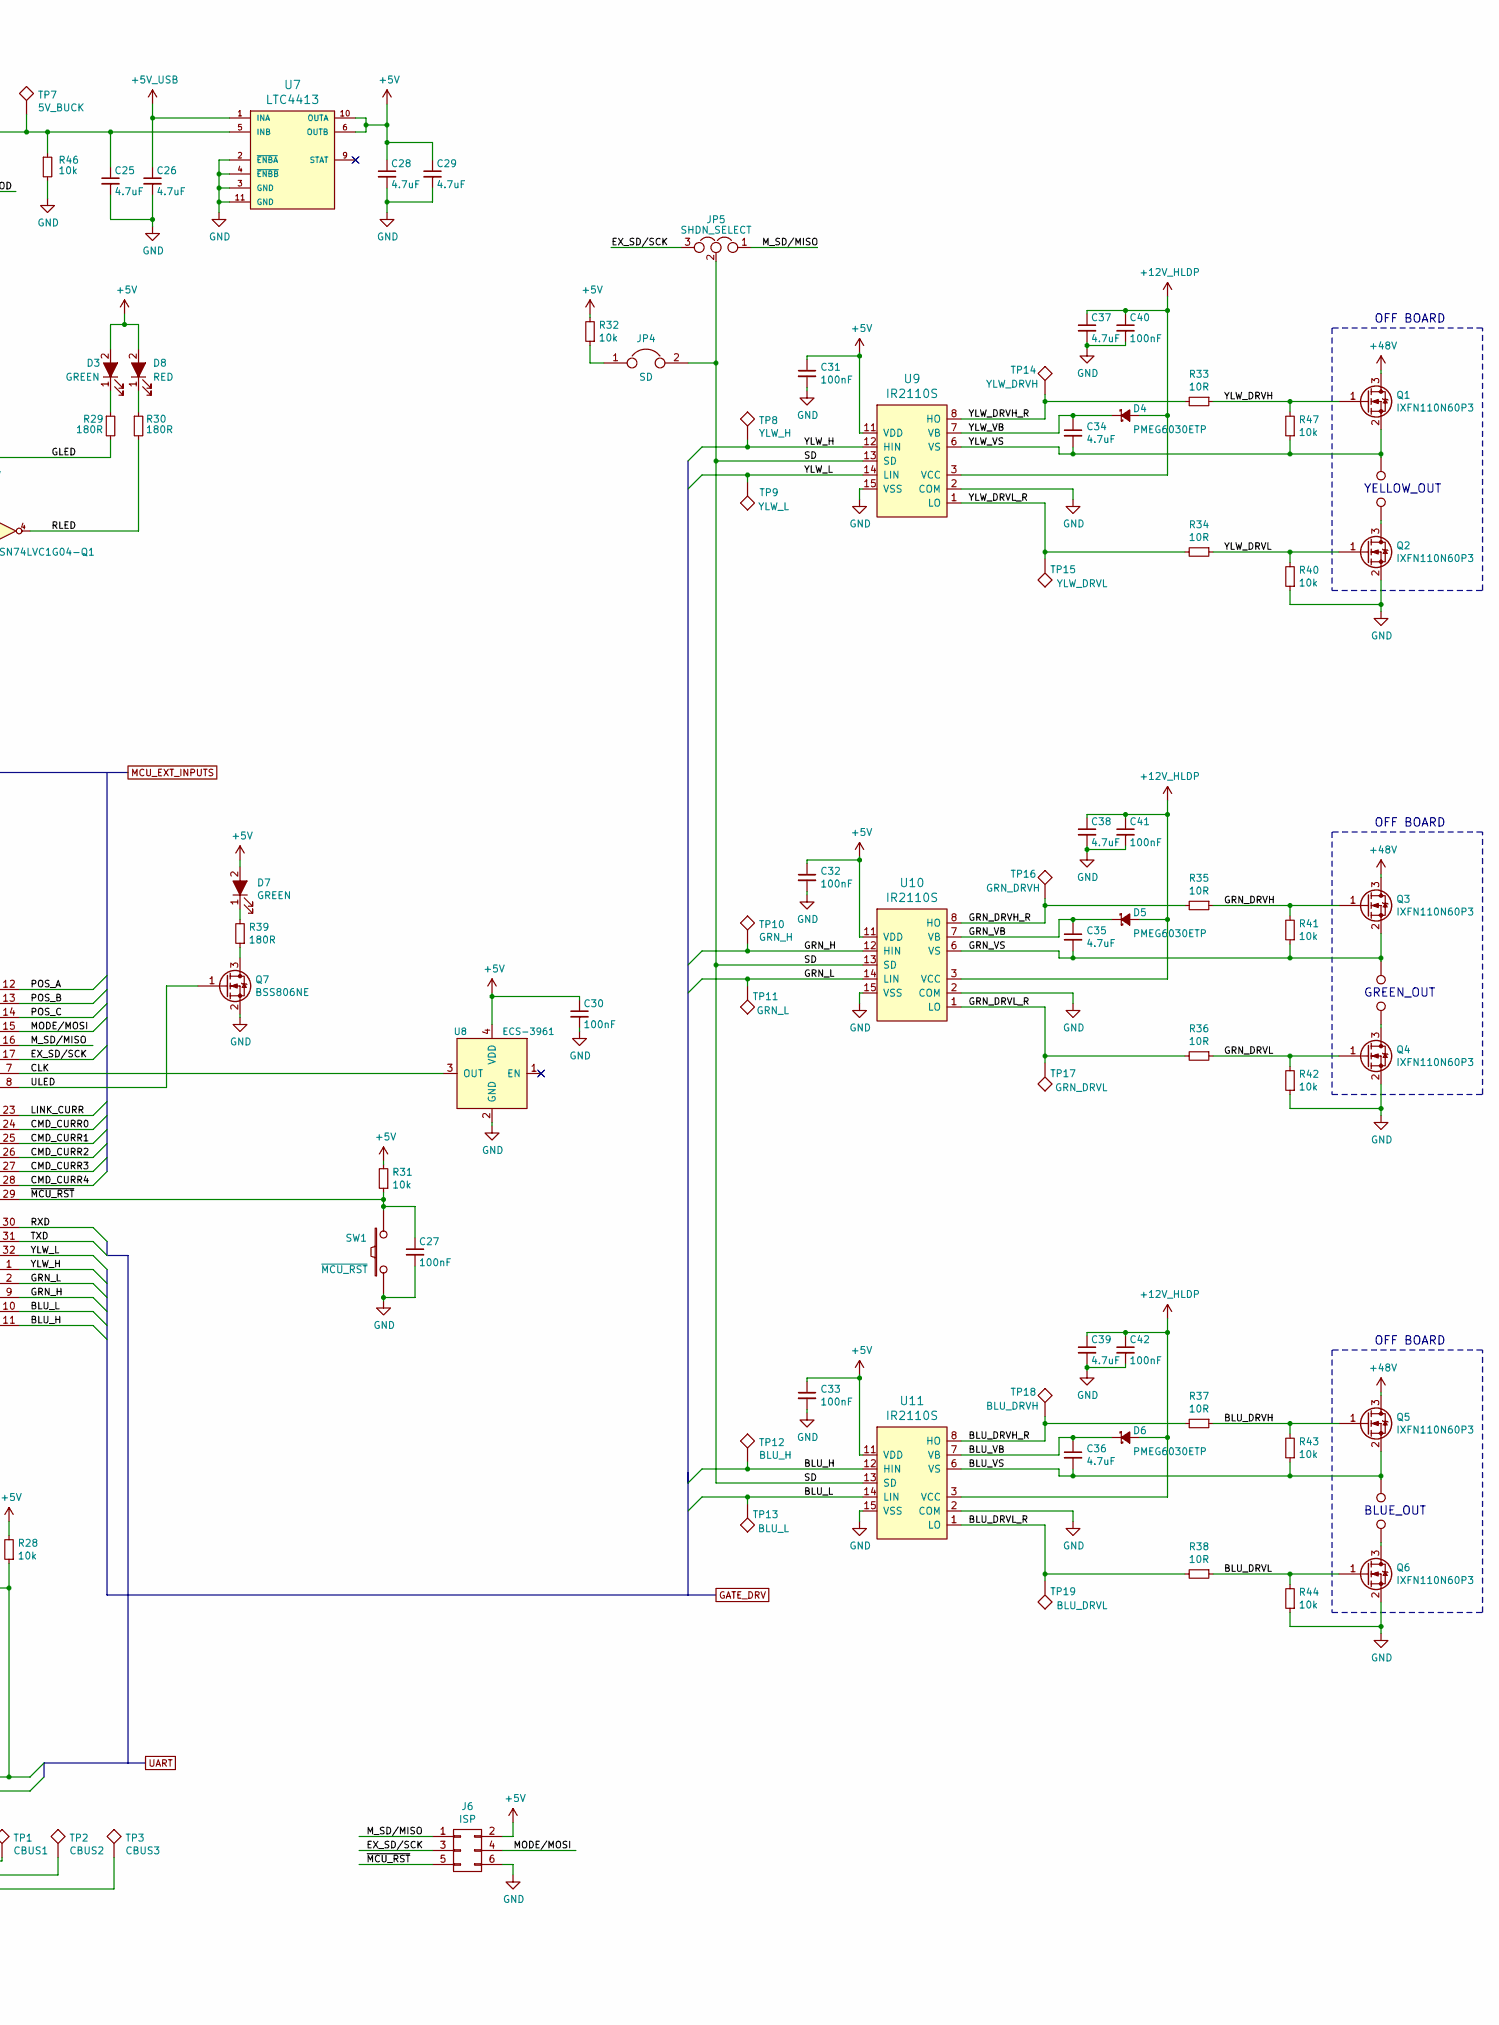
[picture p16: schematic Three_Phase_Inverter_Controller.sch, Three Phase Inverter Controller, part in row 1, column 2]

Parts:
AA1, AA3, AA5: OUT_1_H
AA2, AA4, AA6: OUT_1_L
C1, C6, C8, C9, C10, C11, C12, C13, C15, C16, C17, C18, C19, C22, C23, C24, C27, C30, C31, C32, C33, C40, C41, C42, C44: 100nF; C_0603
C2: 4.5nF; C_0603
C3, C4, C5: 150uF; CP_Elec_10x10.5
C7, C14, C20, C21, C25, C26, C28, C29, C34, C35, C36, C37, C38, C39: 4.7uF; C_1206
C43: 27pF; C_0603
D1, D2, D4, D5, D6: PMEG6030ETP; SOD-128
D3, D7: GREEN; LED_1206
D8: RED; LED_1206
J1: POWER; TerminalBlock_Pheonix_MPT-2.54mm_2pol
J2: HALL; TerminalBlock_Pheonix_MPT-2.54mm_4pol
J3: IN/I2C; Pin_Header_Angled_2x08_Pitch2.54mm
J4: UART; Pin_Header_Angled_1x04_Pitch2.54mm
J5: USB_B; USB-B_62910416121
J6: ISP; Pin_Header_Straight_2x03_Pitch2.54mm
JP1: HALL_P_EN; Pin_Header_Straight_2x01_Pitch2.00mm
JP2: I2C_SDA; Pin_Header_Straight_2x01_Pitch2.00mm
JP3: I2C_SCL; Pin_Header_Straight_2x01_Pitch2.00mm
JP4: SD; Pin_Header_Straight_2x01_Pitch2.00mm
JP5: SHDN_SELECT; Pin_Header_Straight_1x03_Pitch2.54mm
L1: 68uH; BOURNS_SDR0604
Q1, Q2, Q3, Q4, Q5, Q6: IXFN110N60P3; M4_SCREW_OFFSET_9.5_16ths
Q7: BSS806NE; SOT-23
R1: 1M; R_0603
R2, R3, R4, R5, R6, R7, R8, R9, R10, R11, R19, R23, R27, R28, R31, R32, R40, R41, R42, R43, R44, R46, R47: 10k; R_0603
R12, R13, R14, R15, R16: 0R; R_0603
R17: 45.3k; R_0603
R18: 26.1k; R_0603
R20, R21: 27R; R_0603
R22: 6.8k; R_0603
R24: 470k; R_0603
R25: 68k; R_0603
R26: 12k; R_0603
R29, R30: 180R; R_0805
R33, R34, R35, R36, R37, R38: 10R; R_0805
R39: 180R; R_0603
R45: 0.05R; R_1206
SW1: ~MCU_RST; SW_SPST_TL3342
TP1: CBUS1; Test_Point_Keystone_5019_Minature
TP2: CBUS2; Test_Point_Keystone_5019_Minature
TP3: CBUS3; Test_Point_Keystone_5019_Minature
TP4: VIN; Test_Point_Keystone_5019_Minature
TP5: +12V; Test_Point_Keystone_5019_Minature
TP6: 12V_HLDP; Test_Point_Keystone_5019_Minature
TP7: 5V_BUCK; Test_Point_Keystone_5019_Minature
TP8: YLW_H; Test_Point_Keystone_5019_Minature
TP9: YLW_L; Test_Point_Keystone_5019_Minature
TP10: GRN_H; Test_Point_Keystone_5019_Minature
TP11: GRN_L; Test_Point_Keystone_5019_Minature
TP12: BLU_H; Test_Point_Keystone_5019_Minature
TP13: BLU_L; Test_Point_Keystone_5019_Minature
TP14: YLW_DRVH; Test_Point_Keystone_5019_Minature
TP15: YLW_DRVL; Test_Point_Keystone_5019_Minature
TP16: GRN_DRVH; Test_Point_Keystone_5019_Minature
TP17: GRN_DRVL; Test_Point_Keystone_5019_Minature
TP18: BLU_DRVH; Test_Point_Keystone_5019_Minature
TP19: BLU_DRVL; Test_Point_Keystone_5019_Minature
TVS1: PRTR5V0U2X; SOT-143
U1: TPS22810; SOT-23-6
U2: LMR16010; SOIC-8-1EP_3.9x4.9mm_Pitch1.27mm
U3: MCP6561; SOT-23-5
U4: FT230XS; SSOP-16_3.9x4.9mm_Pitch0.635mm
U5: ATMEGA328PB-AU; TQFP-32_7x7mm_Pitch0.8mm
U6: SN74LVC1G04-Q1; SOT-23-5
U7: LTC4413; DFN-10-1EP_3x3mm_Pitch0.5mm
U8: ECS-3961; Oscillator_SMD_EuroQuartz_XO53-4pin_5.0x3.2mm
U9, U10, U11: IR2110S; SOIC-16W_7.5x10.3mm_Pitch1.27mm

Connections:
+3V3_FTDI: C15.1, U4.3 (VCCIO), U4.10 (3V3_OUT), U4.11 (~RESET)
+5V: C8.1, C12.1, C14.1, C17.1, C18.1, C19.1, C20.1, C22.1, C23.1, C28.1, C29.1, C30.1, C31.1, C32.1, C33.1, D3.2 (A), D7.2 (A), D8.2 (A), J6.2, JP1.2, R5.2, R6.2, R10.2, R11.2, R14.2, R22.1, R28.2, R31.2, R32.2, U3.5 (V+), U4.12 (VCC), U5.4 (VCC), U5.18 (AVCC), U5.20 (AREF), U6.5 (+), U7.6 (OUTB), U7.10 (OUTA), U8.4 (VDD), U9.11 (VDD), U10.11 (VDD), U11.11 (VDD)
+5V_BUCK: C21.1, C25.1, C43.1, L1.2, R25.1, R27.1, R46.1, TP7.1, U7.5 (INB)
+5V_USB: C26.1, C44.1, J5.1 (VBUS), R7.2, TVS1.4 (A), U7.1 (INA)
+12V: C1.1, D1.2 (A), R45.1, TP5.1
+12V_HLDP: C3.1, C4.1, C5.1, C6.1, C7.1, C9.1, C37.1, C38.1, C39.1, C40.1, C41.1, C42.1, D1.1 (K), D4.2 (A), D5.2 (A), D6.2 (A), TP6.1, U1.1 (VIN), U2.2 (VIN), U2.3 (EN), U9.3 (VCC), U10.3 (VCC), U11.3 (VCC)
/12V_PROT: C11.1, R16.1, R18.1, U1.6 (VOUT)
/12V_SEN: C13.1, R18.2, R19.1, U3.4 (-)
/AREF: R22.2, R23.1, R24.2, U3.3 (+)
/BLU_DRVH: Q5.1 (G), R37.1, R43.2
/BLU_DRVH_R: R37.2, TP18.1, U11.8 (HO)
/BLU_DRVL: Q6.1 (G), R38.1, R44.2
/BLU_DRVL_R: R38.2, TP19.1, U11.1 (LO)
/BLU_H: TP12.1, U5.11 ((AIN1/PTCXY)PD7), U11.12 (HIN)
/BLU_L: TP13.1, U5.10 ((OC0A/AIN0/PTCXY)PD6), U11.14 (LIN)
/BLU_VB: C36.1, D6.1 (K), U11.7 (VB)
/BLU_VS: AA5.1, C36.2, Q5.2 (S), R43.1, U11.6 (VS)
/BUCK_B: C16.1, U2.1 (BOOT)
/BUCK_FB: C43.2, R25.2, R26.1, U2.5 (FB)
/BUCK_SW: C16.2, D2.1 (K), L1.1, U2.8 (SW)
/CBUS1: TP1.1, U4.14 (CBUS1)
/CBUS2: TP2.1, U4.7 (CBUS2)
/CBUS3: TP3.1, U4.16 (CBUS3)
/CLK: U5.7 ((XTAL1/TOSC1)PB6), U8.3 (OUT)
/CMD_CURR0: J3.9, U5.24 ((SCK1/ADC1/PTCY)PC1)
/CMD_CURR1: J3.7, U5.25 ((ADC2/PTCY)PC2)
/CMD_CURR2: J3.5, U5.26 ((ADC3/PTCY)PC3)
/CMD_CURR3: J3.3, U5.27 ((SDA0/ADC4/PTCY)PC4)
/CMD_CURR4: J3.1, U5.28 ((SCL0/ADC5/PTCY)PC5)
/EX_SD/SCK: J3.10, J6.3, JP5.3, U5.17 ((XCK0/SCK0/PTCXY)PB5)
/GLED: R24.1, R29.2, U3.1, U6.2
/GRN_DRVH: Q3.1 (G), R35.1, R41.2
/GRN_DRVH_R: R35.2, TP16.1, U10.8 (HO)
/GRN_DRVL: Q4.1 (G), R36.1, R42.2
/GRN_DRVL_R: R36.2, TP17.1, U10.1 (LO)
/GRN_H: TP10.1, U5.9 ((OC0B/T1/PTCXY)PD5), U10.12 (HIN)
/GRN_L: TP11.1, U5.2 ((XCK0/T0/PTCXY)PD4), U10.14 (LIN)
/GRN_VB: C35.1, D5.1 (K), U10.7 (VB)
/GRN_VS: AA3.1, C35.2, Q3.2 (S), R41.1, U10.6 (VS)
/I2C_SCL: J3.2, JP2.1, R12.2
/I2C_SDA: J3.4, JP3.1, R13.2
/LINK_CURR: J3.13, U5.23 ((MISO1/ADC0/PTCY)PC0)
/MODE/MOSI: J6.4, U5.15 ((MOSI0/TXD1/OC2A/PTCXY)PB3)
/M_SD/MISO: J6.1, JP5.1, U5.16 ((MISO0/RXD1/PTCXY)PB4)
/PE0: R12.1, R15.1, U5.3 (PE0(PTCXY/SDA1/ICP4/ACO))
/PE1: R13.1, R14.1, U5.6 (PE1(PTCXY/SCL1/T4))
/PE2: J3.6, U5.19 (PE2(PTCY/ADC6/ICP3/~SS1~))
/PE3: J3.8, U5.22 (PE3(PTCY/ADC7/T3/MOSI1))
/PGOOD: C24.1, R27.2, U1.3 (EN/UVLO), U2.6 (PG)
/POS_A: J2.4, R2.1, U5.12 ((CLKO/ICP1/PTCXY)PB0)
/POS_B: J2.3, R3.1, U5.13 ((OC1A/PTCXY)PB1)
/POS_C: J2.2, R4.1, U5.14 ((OC1B/~SS0~/PTCXY)PB2)
/RLED: R30.2, U6.4
/RXD: J4.2, U4.4 (RXD), U5.30 ((RXD0/OC3A/PTCXY)PD0)
/SD: JP4.2, JP5.2, U9.13 (SD), U10.13 (SD), U11.13 (SD)
/TXD: J4.3, R28.1, U4.1 (TXD), U5.31 ((TXD0/OC4A/PTCXY)PD1)
/ULED: Q7.1 (G), U5.8 ((XTAL2/TOSC2)PB7)
/USB+: J5.3 (D+), R20.2, TVS1.3 (D2)
/USB-: J5.2 (D-), R21.2, TVS1.2 (D1)
/USB_R+: R20.1, U4.8 (USBDP)
/USB_R-: R21.1, U4.9 (USBDM)
/VBUS_DET: R7.1, R8.2, U4.15 (CBUS0)
/VIN: J1.2, R45.2, TP4.1
/YLW_DRVH: Q1.1 (G), R33.1, R47.2
/YLW_DRVH_R: R33.2, TP14.1, U9.8 (HO)
/YLW_DRVL: Q2.1 (G), R34.1, R40.2
/YLW_DRVL_R: R34.2, TP15.1, U9.1 (LO)
/YLW_H: TP8.1, U5.1 ((OC2B/INT1/PTCXY)PD3), U9.12 (HIN)
/YLW_L: TP9.1, U5.32 ((OC3B/OC4B/INT0/PTCXY)PD2), U9.14 (LIN)
/YLW_VB: C34.1, D4.1 (K), U9.7 (VB)
/YLW_VS: AA1.1, C34.2, Q1.2 (S), R47.1, U9.6 (VS)
/~MCU_RST: C27.1, J6.5, R31.1, SW1.2, U5.29 ((~RESET~)PC6)
GND: C1.2, C2.1, C3.2, C4.2, C5.2, C6.2, C7.2, C8.2, C9.2, C10.2, C11.2, C12.2, C13.2, C14.2, C15.2, C17.2, C18.2, C19.2, C20.2, C21.2, C22.2, C23.2, C24.2, C25.2, C26.2, C27.2, C28.2, C29.2, C30.2, C31.2, C32.2, C33.2, C37.2, C38.2, C39.2, C40.2, C41.2, C42.2, C44.2, D2.2 (A), J1.1, J2.1, J3.11, J3.12, J3.14, J3.15, J3.16, J4.1, J4.4, J5.4 (GND), J6.6, Q2.2 (S), Q4.2 (S), Q6.2 (S), Q7.2 (S), R1.2, R9.1, R15.2, R17.2, R19.2, R23.2, R26.2, R40.1, R42.1, R44.1, R46.2, SW1.1, U1.2 (GND), U2.7 (GND), U2.9 (GND), U3.2 (V-), U4.5 (GND), U4.13 (GND), U5.5 (GND), U5.21 (GND), U6.3 (-), U7.2 (~ENBA), U7.3 (GND), U7.4 (~ENBB), U7.11 (GND), U8.2 (GND), U9.2 (COM), U9.15 (VSS), U10.2 (COM), U10.15 (VSS), U11.2 (COM), U11.15 (VSS)
unnamed: AA2.1, Q2.3 (D)
unnamed: AA4.1, Q4.3 (D)
unnamed: AA6.1, Q6.3 (D)
unnamed: C2.2, J5.5 (Shield), R1.1, TVS1.1 (K)
unnamed: C10.1, U1.4 (CT)
unnamed: D3.1 (K), R29.1
unnamed: D7.1 (K), R39.2
unnamed: D8.1 (K), R30.1
unnamed: JP1.1, R2.2, R3.2, R4.2
unnamed: JP2.2, R5.1, R6.1
unnamed: JP3.2, R10.1, R11.1
unnamed: JP4.1, R32.1
unnamed: Q7.3 (D), R39.1
unnamed: R8.1, R9.2
unnamed: R16.2, U1.5 (QOD)
unnamed: R17.1, U2.4 (RT/SYNC)

Notes on the sheet:
OFF BOARD
YELLOW_OUT
GREEN_OUT
BLUE_OUT
ATMEGA328P/PB STRAPPING
ATMEGA328P: R12, R13 = DNP ATMEGA328PB: C8, R14, R15 = DNP DEFAULT CONFIG: ATMEGA328PB
Trip point (Low to High): 10.628 VDC (12V_HLDP) Trip point (High to Low): 10.773 VDC (12V_HLDP)

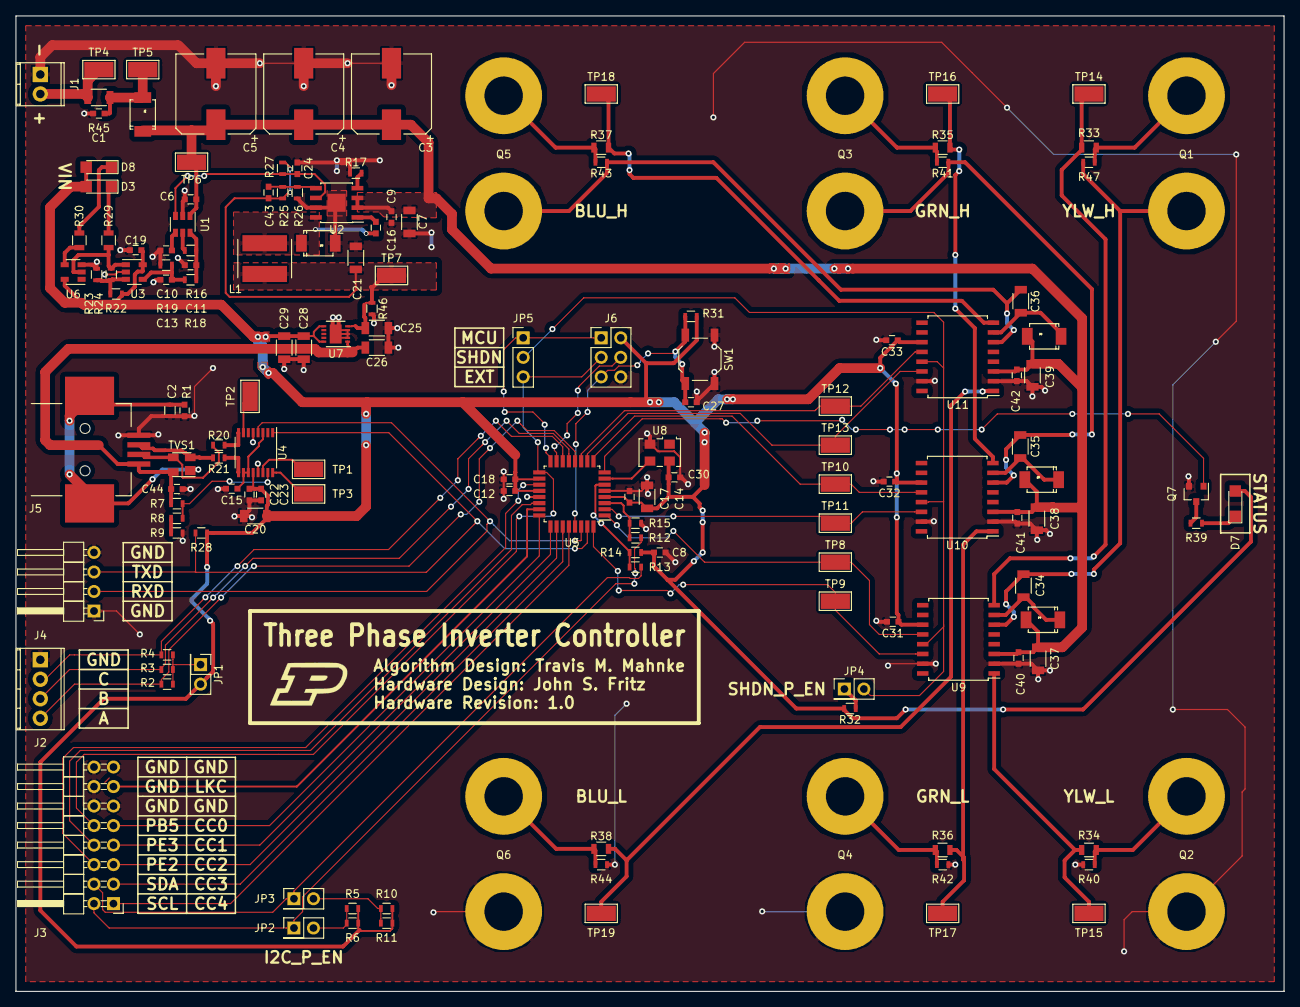
[picture p17: board Three_Phase_Inverter_Controller.kicad_pcb from above]

Board: 2 copper layers, 165.1 x 127.0 mm, 150 parts (0 on the bottom side), 86 nets.
