jfri2/EV_FET_DRIVER/(commit log)

2017-04-05 Added datasheets. Selected oscillator
    [EV_FET_DRIVER.sch]
2017-04-06 Added wire
    [EV_FET_DRIVER.sch]
2017-04-09 Hardware architecture done. Starting schematic drafting
    [EV_FET_DRIVER.sch]
2017-04-09 renamed project. Added more datasheets
    [Three_Phase_Inverter_Controller.kicad_pcb, Three_Phase_Inverter_Controller.sch]
2017-04-13 Updated schematic
    [Three_Phase_Inverter_Controller.sch]
2017-04-13 Regenerated schematic PDF
    [Three_Phase_Inverter_Controller.sch]
2017-04-13 Added Diode OR to Power Supply
    [Three_Phase_Inverter_Controller.sch]
2017-04-13 Annotated schematic
2017-04-18 Pre-release v0.3 Schematic
    [Three_Phase_Inverter_Controller.sch]
2017-04-19 Update to pre-release v0.4
    [Three_Phase_Inverter_Controller.sch]
2017-04-21 Updated BOM & finished SCH
    [Three_Phase_Inverter_Controller.csv, Three_Phase_Inverter_Controller.ods, Three_Phase_Inverter_Controller.sch]
2017-04-21 Regenerate schematic PDF
2017-04-22 Assigned footrpints for most components, tweaked BOM
    [Three_Phase_Inverter_Controller.csv, Three_Phase_Inverter_Controller.kicad_pcb, Three_Phase_Inverter_Controller.ods, Three_Phase_Inverter_Controller.sch, Three_Phase_Inverter_Controller.xlsx]
2017-04-26 Changed connector, started layout, save before reloading new netlist
    [Three_Phase_Inverter_Controller.sch, Three_Phase_Inverter_Controller.xlsx]
2017-04-26 More layout done
    [Three_Phase_Inverter_Controller.kicad_pcb, _saved_Three_Phase_Inverter_Controller.sch]
2017-04-26 Generate dimension check PDF
    [Three_Phase_Inverter_Controller.kicad_pcb, Three_Phase_Inverter_Controller.sch, _saved_Three_Phase_Inverter_Controller.sch]
2017-04-26 Updated BOM?
    [Three_Phase_Inverter_Controller.kicad_pcb, Three_Phase_Inverter_Controller.xlsx]
2017-04-28 Did stuff
    [Three_Phase_Inverter_Controller.kicad_pcb, Three_Phase_Inverter_Controller.sch]
2017-05-03 Started layout. Minor adjustments to schematic to make layout easier.
    [Three_Phase_Inverter_Controller.kicad_pcb, Three_Phase_Inverter_Controller.ods, Three_Phase_Inverter_Controller.sch, Three_Phase_Inverter_Controller.xlsx]
2017-05-03 More routing and component placement complete
    [Three_Phase_Inverter_Controller.kicad_pcb, Three_Phase_Inverter_Controller.sch]
2017-05-04 Add new 3D models/Routed more
    [Three_Phase_Inverter_Controller.kicad_pcb]
2017-05-10 Finished initial component placement
    [Three_Phase_Inverter_Controller.kicad_pcb, Three_Phase_Inverter_Controller.xlsx, _saved_Three_Phase_Inverter_Controller.sch]
2017-05-11 did more routing
    [Three_Phase_Inverter_Controller.kicad_pcb]
2017-05-12 Finished initial board layout
    [Three_Phase_Inverter_Controller.kicad_pcb, _saved_Three_Phase_Inverter_Controller.sch]
2017-05-15 Finished PCB, changed routing, regenerated schematic, generated gerbers
    Put EXT_SHDN line in instead of ULED to external connector, changed
    routing to reflect that. Added finishing touches to PCB silkscreen.
    [Three_Phase_Inverter_Controller-B.Cu.gbr, Three_Phase_Inverter_Controller-B.Mask.gbr, Three_Phase_Inverter_Controller-B.Paste.gbr, Three_Phase_Inverter_Controller-B.SilkS.gbr, Three_Phase_Inverter_Controller-Edge.Cuts.gbr, Three_Phase_Inverter_Controller-F.Cu.gbr, Three_Phase_Inverter_Controller-F.Mask.gbr, Three_Phase_Inverter_Controller-F.Paste.gbr]
2017-05-29 Started board bring up
